marcorispoli/PCB-26-349/ORCAD/Specifiche Per Il Routing.docx

## Descrizione

La scheda in oggetto deriva dalla PCB/05-190-3 dalla quale sono stati eliminati alcuni blocchi funzionali ed è stato utilizzato il nuovo controllore della famiglia SAME come tutte le schede ultimamente prodotte.

Nello sbroglio delle piste e sul piazzamento dei componenti bisognerà rigorosamente rispettare gli isolamenti imposti tra aree galvanicamente separate.

All’interno della scheda esistono le seguenti aree circuitali galvanicamente separate:

- Area 24V: tale area fa capo al Ground con label “0”. A tale area fanno capo:
  - Il 24VDC di alimentazione della scheda;
  - Le uscite verso lo starter (conn. J11)
  - Le uscite verso L’interfaccia sincronismi (J12)
  - L’uscita del CAN-BUS.
- Area Microcontrollore: tale area fa capo al Ground con label “GND”. A quest’area attiene tutta la sezione di comando e lettura verso le aree attorno ad essa.
- Area Masmetro: tale area fa capo al Ground con label “GND_mAs”. A quest’area appartengono tutti i componenti della sezione mAsmetro.
- Area HV: a tale area isolate appartengono due zone di massa, “GND_HV” e “GND_HV1”. Tali zone sono unite a stella per ragioni funzionali (riduzione rumore da commutazione) ma non sono zone fra loro isolate galvanicamente.

Le piste e i componenti adiacente di aree isolate, reciprocamente, devono garantire un distanziamento minimo di 8mm, eventualmente rinforzabili con setti di 2 mm.

Tali setti inoltre devono obbligatoriamente essere inseriti al di sotto dei componenti di isolamento:

- U3, U21, U22, U19,U11,U5, U7,U26,U24,U1, U49,U50,U51,U52,U53,U54,U44,U45,U46,U47,U48,U32,U34,U30.

Il piazzamento si predilige sul lato componenti: tuttavia, a torto collo, potrà essere effettuato anche sul lato piste se il piazzamento o il routing dovesse essere critico, considerando il requisito di isolamento imposto.

La scheda dovrà essere sviluppata su 4 strati: eventualmente l’isolamento potrà essere garantito anche tracciando piste su Layers differenti.

## Parti Circuitali Derivate Da PCB 05/190

Allo scopo di riutilizzare quanto già fatto (e che funziona) si suggerisce di ispirarsi al routing della PCB190 per i componenti che attengono a UC3841 e PULSES, compreso anche la posizione dei connettori (facilmente identificabili tra le due schede anche se con references differenti)

## Dimensioni

La Scheda come punto di partenza dovrebbe essere alta 15cm (come la PCB190) e larga fino a J14 della PCB190, ora diventato J5.

## Piazzamento Suggerito

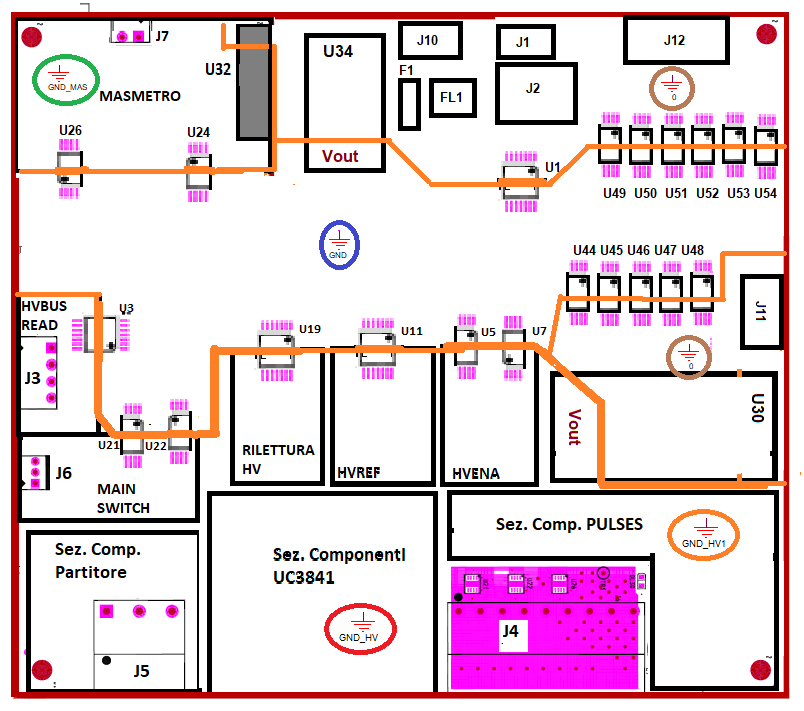
[picture p1: figure]
