marcorispoli/PCB-26-349/LST/RAZIONALIZZAZIONE LISTA PARTI PCB05-190-3.odt

REGOLATORI DC/DC

Id | PN/REFERENCE | ALTERNATIVE
1 | R-785.0-0.5 (RECOM) | TSR 0.5-2450 (TRACO POWER)
2 | R-78C15-1.0 (RECOM) | TSR 1-24150 (TRACO POWER)
3 | R-78C12-1.0 (RECOM) | TSR 1-24120 (TRACO POWER)
4 | ECOS1JA472CA oppure SLP472M050C5P3 | Alternativa a 85°, stesse dimensioni
5 | BNX002-01 | BNX012-01
6 | UC3841DW (obsoleto) | UC2841DW
7 | FSL400B THERMAL GAP 60x35mm | Equivalente ?
8 | DAC8512FSZ | DAC7611U TEXAS INSTRUMENT

ELIMINAZIONE COMPONENTI PER TENSIONE GRIGLIA (MAI USATA)

Id | REFERENCE | P/N/Prezzo
1 | J10 | MLSS156-2 (0.18)
2 | JP10 | Jumper
3 | OC12 | MOC3063SR2M (0.2)
4 | Q26 | BSS138K (0.01)
5 | R180
6 | R179
7 | TP31,TP33 | Test Points (0.3)
8 | PD5 | MB4S (0.2)
9 | C91
10 | C92 | ECA2CM100 (0.2)
11 | R170
12 | U38 | LR8N8-G (0.41)
13 | R172,R173,R176,R181,R182
14 | OC11 | TCMT4106 (0.5)
15 | R174,R175,R177,R178

SELEZIONE 2 FUOCHI INVECE CHE 4 FUOCHI ?:

Id | REFERENCE | P/N/Prezzo
1 | K11,K12 | 32.21.7.012.2000 RELAY PTH ( 2x 1,32)
NOTA: OCCORRE AGGIUNGERE UN PONTICELLO TRA PIN 12 e 14 DI K11
