marcorispoli/PCB-26-349/LST/ReleaseNote_LP05-190-3-ASSY00_r03.docx

# MODIFICA LISTA PARTI PCB-05-190 ASSY00

Le seguenti modifiche devono essere apportate alla lista parti in ASSY00:

Reference | Posizione precedente | Valore precedente | Nuova posizione | Nuovo valore | Note
R127 | 86 | 10K | 125 | 2K7 | Cambio valore
R136 | 86 | 10K | 87 | 6K8 | Cambio valore
