marcorispoli/PCB-26-349/LST/LP26-349-0.pdf

LISTA PARTI SCHEDA 26-349-0
Pos. Qtà Rif | Descrizione | Value | Package | PN | Costruttore | Note
1 | 41 C1,C2,C4,C5,C6,C8,C9,C10,C11
,C13,C14,C15,C27,C29,C30,C31 ,C33,C40,C51,C53,C55,C56,C57 ,C58,C60,C61,C62,C63,C64,C66 ,C67,C68,C87,C88,C89,C90,C92 ,C100,C101,C102,C103 | MLCC - SMD/SMT 50V 0.1uF X7R 0603 10% | 100nF | SMD0603 | C0603C104K5RACTU | KEMET
2 | 8 C7,C21,C32,C35,C43,C52,C54,
| C91 | MLCC - SMD/SMT 50V 0.01uF X7R 0603 5% | 10nF | SMD0603 | C0603C103J5RACTU | KEMET
3 | 10 C12,C16,C17,C18,C22,C23,C24,
| C37,C39,C50 | MLCC - SMD/SMT 25V 1uF X7R 0805 10% | 1uF | SMD0805 | 08053C105K4Z2A | KYOCERA
4 | 1 C19 | MLCC - SMD/SMT 100V 1nF COG 0805 5% | 1nF | SMD0805 | 08051A102J4T2A | KYOCERA
5 | 4 C20,C42,C44,C45 | MLCC - SMD/SMT 50V 1n5F COG 0805 5% | 1n5F | SMD0805 | C0805C152J5GACTU | KEMET
6 | 12 C25,C26,C70,C72,C75,C76,C78,
| C79,C81,C82,C84,C104 | Cond.Elt.Tantalio solido 35V SIZE C | 4u7 | 6032-28 | T491C475K035AT | KEMET
7 | 1 C28 | MLCC - SMD/SMT 2KV 820pF X7R1210 10% | 820pF | SMD1210 | 1210GC821KAT2A | KYOCERA
8 | 1 C34 | MLCC - SMD/SMT 2K5V 5n6F X7R1210 10% | 5n6F | SMD1825 | 825WC562KAT2A | KYOCERA
9 | 2 C36,C41 | MLCC - SMD/SMT 100V 470pF COG 0805 5% | 470pF | SMD0805 | 08051A471JAT2A | KYOCERA
10 | 1 C38 | MLCC - SMD/SMT 50V 47nF X7R 0603 10% | 47nF | SMD0805 | C0805C473K5RAC | KEMET
11 | 1 C46 | MLCC - SMD/SMT 100V 330pF COG 0805 5% | 330pF | SMD0805 | C0805C331J1GAC | KEMET
12 | 2 C47,C48 | MLCC - SMD/SMT 50V 56pF COG 0805 5% | 56pF | SMD0805 | C0805C560J5GACTU | KEMET
13 | 2 C49,C69 | Cond.Elt.Tantalio solido 35V SIZE D | 22uF | 7343-43 | T491X226K035AT7280 KEMET
14 | 1 C59 | MLCC - SMD/SMT 10V 10uF X7R 0805 10% | 10uF | SMD0805 | C0805C106K8RACTU | KEMET
15 | 1 C65 | MLCC - SMD/SMT 35V 4u7F X7R 1206 10% | 4u7 | SMD1206 | C1206C475K6RACTU | KEMET
17 | 6 C77,C80,C83,C86,C93,C94 | Safety Capacitors WCAP-CSSA X&Y Safety 470pF 5kV
| | 10% 1812 | 470pF | SMD1812 | 8853522110011 | WURTH
18 | 4 DL7,DL8,DL9,DL10 | Diodo led smd 0805 | VERDE | SMD0805 | KP-2012SGD | KINGBRIGHT
19 | 1 DL22 | Diodo led smd 0805 | BLU | SMD0805 | KP-2012PBC | KINGBRIGHT
20 11 DL24,DL26,DL27,DL28,DL29,DL
| 30,DL31,DL32,DL33,DL34,DL35 | Diodo led 90 gradi smd | GIALLO | APA2106SYCK/J3-
| | | | PRV

APA2106SYCK/J3-PRV KINGBRIGHT

21 | 1 DL25 | Diodo led 90 gradi smd | ROSSO | APA2106SECKJ3PRV APA2106SECK/J3-PRV KINGBRIGHT
22 | 1 D1 | ESD Protection compatible with CAN BUS | ESD2CAN24DBZRQ1 SOT23-3 | ESD2CAN24DBZRQ1 | TEXAS
23 | 8 D2,D4,D13,D14,D17,D18,D21,D
| 22 | Small Signal Switching Diodes SINGLE JUNC. 75V 4.0NS
| | COMP | 1N4148WT | SOD-523F-2 | 1N4148WT | ONSEMI
24 | 8 D5,D6,D7,D8,D9,D10,D11,D12 Rectifiers Diode, Superfast, SMA, 50V, 1A, 150C | ES1A | DO-214AC-2 | ES1A | DIOTEC
25 | 4 D15,D16,D19,D20 | Rectifiers 1.0A 1000V | RS1M-13-F | SMA-2 | RS1M-13-F | DIODES
26 | 1 D23 | Zener Diodes Zener Diode 3.0V 1000mW Surface Mount | PDZVTR3.0B | SOD-128-2 | PDZVTR3.0B | ROHM
27 | 2 D24,D25 | Rectifiers Diode, Superfast, SMA, 100V, 1A, 150C | ES1B | SMA | ES1B | DIOTEC
28 | 1 D26 | DIODO EDS BIDIREZIONALE | ESD5V0D3B-TP | SOD-323-2 | ESD5V0D3B-TP | MCC
29 | 1 FL1 | Circuiti filtro EMI 40 DB 50V 15A LEADED | BNX012-01 | | BNX012-01 | MURATA
30 | 1 F1 | FUSIBILE +PORTAFUSIBILE 0154002.DRT | 2A | | 0154002.DRT | LITTELFUSE
32 | 2 JP1,JP2 | HEADER DRITTO 2 PIN PASSO 2.54 | SIP | THT | TSW-102-09-T-S-RA | SAMTEC
33 | 1 J1 | NANOFIT HDR RA DLR 4CKT TIN BLK | 105314-1104 | | 105314-1104 | MOLEX
34 | 1 J2 | Connettore RJ45 8 Posizioni 90 gradi con leds | RJHSE538W01B | RJ45 | RJHSE538W01B | AMPHENOL
LP26-349-0.xlsx | 08/08/2026 | 1di4

Pos. Qtà Rif | Descrizione | Value | Package | PN | Costruttore | Note
35 | 2 J4,J5 | Mini-Fit Jr. Header, Dual Row, 10 vie | 39-30-1102 | 39-30-1102 | MOLEX
36 | 1 J8 | WR-BHD 2.54mm Male 6P Strt Gold Box Hdr | 61200621621 THT | 61200621621 | WURTH
37 | 1 J9 | CONN.HEADER 2X5 RIGHT ANG | 105314-2310 | THT | 105314-2310 | MOLEX
38 | 2 J10,J13 | CONN.HEADER 2X1 DRITTO P2 | 448179 | THT | 448179 | MOLEX
39 | 1 J11 | CONN.HEADER 2X3 DRITTO P2 | 105314-2306 | THT | 105314-2306 | MOLEX
40 | 1 J12 | TTerminali e capicorda 2.54MM CGRIDIII HDR 8P V DR
SHRD AU-E
105314-2208 | THT | 105314-2208 | MOLEX
41 | 1 K1 | RELE' STATO SOLIDO SMD | CPC1017NTR | SOP-4 | CPC1017NTR | IXYS
42 | 1 L1 | Filtro Modo Comune x CAN BUS | DLW32SH101XF2L | DLW32SH101XF2L | DLW32SH101XF2L | MURATA
43 | 2 L2,L3 | Ferrite Bead | BLM18BD102 | SMD0603 | BLM18BD102SN1D | MURATA
44 | 1 L4 | Common Mode Choke 470uH | 470uH | 744272471 | WUERTH
45 | 1 PT1 | Resettable Fuses - PPTC PTS0603 0.05A, 15V | PTS060315V005 | PTS060315V005 | EATON
46 | 2 P1,P3 | Trimmer Resistors - Through Hole 3/8" 5Kohms Sealed
Vertical Adjust
5K | 3296W-1-502LF | BOURNS
47 | 1 P2 | Trimmer Resistors - Through Hole 3/8" 10Kohms Sealed
Vertical Adjust
10K | 3296W-1-103LF | BOURNS
48 | 1 P4 | Trimmer Resistors - Through Hole 3/8" 20Kohms Sealed
Vertical Adjust
20K | 3296W-1-203LF | BOURNS

49 32 Q1,Q2,Q3,Q4,Q6,Q9,Q10,Q11,
Q14,Q15,Q16,Q17,Q18,Q19,Q2 0,Q21,Q22,Q23,Q24,Q25,Q26,Q 27,Q28,Q29,Q30,Q31,Q32,Q33, Q34,Q35,Q36,Q37
MOSFETs 60V 115mA N-Channel | 2N7002LT1G | SOT23 | 2N7002LT1G | ON
50 | 1 Q5 | Bipolar Transistors - BJT BJT, SOT-323, 45V, 100mA, PNP BC857BW | SOT323 | BC857BW | DIOTEC
51 | 2 Q7,Q8 | MOSFETs 60V N-Channel Enhancement Mode MOSFET PJE8472B_R1_00001 SOT-523-3 | PJE8472B_R1_00001 | PANJIT
52 | 1 R1 | Resistore thick film 1/10W 1% 0603 | 33R | SMD0603 | MULTICOMP
53 | 3 R2,R172,R173 | Resistore thick film 1/10W 1% 0603 | 120R | SMD0603 | MULTICOMP
54 14 R5,R7,R20,R40,R52,R56,R60,R
61,R77,R93,R103,R126,R132,R 189
Resistore thick film 1/10W 1% 0603 | 1K | SMD0603 | MULTICOMP
55 | 3 R6,R15,R46 | Resistore thick film 1/10W 1% 0603 | 2K2 | SMD0603 | MULTICOMP
56 10 R8,R66,R69,R87,R119,R128,R1
35,R141,R151,R166
Resistore thick film 1/10W 1% 0603 | 280R | SMD0603 | MULTICOMP

57 22 R9,R16,R19,R22,R23,R24,R59, R67,R70,R79,R89,R91,R94,R10 8,R109,R116,R125,R134,R139, R149,R160,R171

Resistore thick film 1/10W 1% 0603 | 10K | SMD0603 | MULTICOMP
58 | 1 R10 | Resistore thick film 1/4W 1% 1206 | 1K5 | SMD1206 | MULTICOMP
59 18 R11,R12,R13,R18,R21,R68,R71,
| R72,R73,R78,R90,R92,R111,R1 12,R118,R147,R157,R163 | Resistore thick film 1/10W 1% 0603 | 100K | SMD0603 | MULTICOMP
60 | 3 R14,R105,R114 | Resistore thick film 1/4W 1% 1206 | 1K3 | SMD1206 | MULTICOMP
61 | 9 R17,R55,R88,R100,R101,R102,
| R150,R159,R169 | Resistore thick film 1/10W 1% 0603 | 3K3 | SMD0603 | MULTICOMP
62 | 1 R25 | Resistore thick film 1/8W 1% 0805 | 2K2 | SMD0805 | MULTICOMP
63 | 2 R26,R64 | Resistore thick film 1/8W 1% 0805 | 3K3 | SMD0805 | MULTICOMP
64 | 2 R27,R39 | Resistore thick film 1/8W 1% 0805 | 1K | SMD0805 | MULTICOMP
LP26-349-0.xlsx | 08/08/2026 | 2di4

65 | 3 R28,R29,R30 | Resistore thick film 1/4W 1% 1206 | 1R | SMD1206 | MULTICOMP
66 | 1 R31 | Resistore thick film 1/4W 1% 1206 | 10K | SMD1206 | MULTICOMP
67 | 1 R32 | Resistore thick film 1/4W 1% 1206 | 18K | SMD1206 | MULTICOMP
68 | 2 R33,R204 | Resistore thick film 2W 1% 2512 | 33K | SMD 2512 | MULTICOMP
69 | 7 R34,R35,R36,R41,R42,R44,R45 Resistore thick film 1/4W 1% 1206 | 130K | SMD1206 | MULTICOMP
70 | 1 R37 | Resistore thick film 1/4W 1% 1206 | 220K | SMD1206 | MULTICOMP
71 | 1 R38 | Resistore thick film 1/8W 1% 0805 | 20K | SMD0805 | MULTICOMP
72 | 2 R43,R47 | Resistore thick film 1/4W 1% 1206 | 4K7 | SMD0805 | MULTICOMP
73 | 1 R48 | Resistore thick film 1/8W 1% 0805 | 5K6 | SMD0805 | MULTICOMP
74 | 1 R49 | Resistore thick film 1/8W 1% 0805 | 470R | SMD0805 | MULTICOMP
75 | 1 R50 | Resistore thick film 1/8W 1% 0805 | 4K32 | SMD0805 | MULTICOMP
76 | 1 R51 | Resistore thick film 1/10W 1% 0603 | 1K2 | SMD0603 | MULTICOMP
77 | 1 R53 | Resistore thick film 1/10W 1% 0603 | 8K45 | SMD0603 | MULTICOMP
78 27 R54,R123,R124,R131,R133,R13
| 8,R145,R146,R148,R155,R158,
| R164,R165,R170,R178,R179,R1
| 81,R183,R185,R187,R191,R193,
| R196,R197,R199,R201,R203 | Resistore thick film 1/10W 1% 0603 | 33K | SMD0603 | MULTICOMP
79 | 1 R57 | Resistore thick film 1/8W 1% 0805 | 390R | SMD0805 | MULTICOMP
80 | 1 R58 | Resistore thick film 1/10W 1% 0603 | 18K | SMD0603 | MULTICOMP
81 | 1 R62 | Resistore thick film 1/8W 1% 0805 | 10R | SMD0805 | MULTICOMP
82 | 1 R63 | Resistore thick film 1/8W 1% 0805 | 120K | SMD0805 | MULTICOMP
83 | 1 R65 | Resistore thick film 1/8W 1% 0805 | 220R | SMD0805 | MULTICOMP
84 | 1 R74 | Resistore thick film 1/10W 0.1% 10PPM 0603 | 2K67 | SMD0603 | RP0603BRD072K67L
85 | 2 R75,R84 | Resistore thick film 1/8W 1% 0805 | 10K | SMD0805 | MULTICOMP
86 | 1 R76 | Resistore thick film 1/8W 1% 0805 | 2K | SMD0805 | MULTICOMP
87 | 1 R80 | Resistore thick film 1/2W 1% 2512 | 100R | SMD2512 | MULTICOMP
88 | 1 R81 | Resistore thick film 1/10W 0.1% 10PPM 0603 | 33K | SMD0603 | RT0603BRC0733KL
89 | 1 R82 | Resistore thick film 1/10W 0.1% 10PPM 0603 | 100K | SMD0603 | RT0603BRB07100KL
90 | 1 R83 | Resistore thick film 1/10W 0.1% 10PPM 0603 | 11K | SMD0603 | RT0603BRD0711KL
91 | 1 R85 | Resistore thick film 1/10W 0.1% 10PPM 0603 | 14K | SMD0603 | RT0603BRB0714KL
92 | 1 R86 | Resistore thick film 1/8W 1% 0805 | 47R | SMD0805 | MULTICOMP
93 | 1 R95 | Resistore thick film 1/10W 1% 0603 | 330R | SMD0603 | MULTICOMP
94 | 1 R104 | Resistore thick film 1/4W 1% 1206 | 1K8 | SMD1206 | MULTICOMP
95 | 1 R106 | Resistore thick film 1/10W 1% 0603 | 12K | SMD0603 | MULTICOMP
96 | 2 R107,R115 | Resistore thick film 1/10W 1% 0603 | 15K | SMD0603 | MULTICOMP
97 | 1 R110 | Resistore thick film 1/10W 1% 0603 | 2K | SMD0603 | MULTICOMP
98 | 3 R113,R117,R188 | Resistore thick film 1/10W 1% 0603 | 4K7 | SMD0603 | MULTICOMP
99 16 R120,R121,R122,R129,R130,R1
| 36,R137,R142,R143,R144,R152,
| R153,R154,R162,R167,R168 | Resistore thick film 1/4W 1% 1206 | 2K | SMD1206 | MULTICOMP
100 1 R127 | Resistore thick film 1/10W 1% 0603 | 2K | SMD1206 | MULTICOMP
101 3 R140,R156,R161 | Resistore thick film 1/10W 1% 0603 | 47K | SMD0603 | MULTICOMP
102 1 R174 | Resistore thick film 1/8W 1% 0805 | 330K | SMD0805 | MULTICOMP
103 1 R175 | Resistore thick film 1/8W 1% 0805 | 22K | SMD0805 | MULTICOMP
104 13 R176,R177,R180,R182,R184,R1 86,R190,R192,R194,R195,R198, R200,R202 | Resistore thick film 1/10W 1% 0603 | 680R | SMD0603 | MULTICOMP
LP26-349-0.xlsx | 08/08/2026 | 3di4

105 12 TP2,TP5,TP6,TP10,TP11,TP13, TP15,TP16,TP23,TP24,TP26,TP 27

| Test Plugs & Test Jacks TEST POINT YELLOW | YEL | | | 5004 KEYSTONE
106 4 TP3,TP4,TP7,TP25 | Test Plugs & Test Jacks TEST POINT BLK .063 | BLK | | | 5006 KEYSTONE
107 2 TP12,TP28 | Test Plugs & Test Jacks TEST POINT (GREEN) | GRN | | | 5116 KEYSTONE
108 2 TP14,TP29 | Test Plugs & Test Jacks TEST POINT WHITE .040 | WHT | | | 5002 KEYSTONE
109 1 U1 | Digital Isolators Reinforced, fast, low-power 2-channel di | MAX22246CAWA/V+ SOIC-8 | MAX22246CAWA/V+ | ANALOG DEVICE
110 1 U2 | CAN Interface IC High-speed CAN transceiver | TJA1050T/CM,118 | SOIC-8 | TJA1050T | NXP
111 2 U3,U19 | Amplificatori di isolamento High Stability Isolated Error
| Amplifier | ADuM3195BRQZ | QSOP-16 | ADuM3195BRQZ | ANALOG DEVICE
112 2 U4,U6 | Logic Gates SSOP5 IC LOGIC 2INPUT AND GATE | BD7LS08ZG-CTL | SSOP-5 | BD7LS08ZG-CTL | ROHM
113 19 U5,U7,U21,U22,U26,U35,U36,U 41,U44,U45,U46,U47,U48,U49,U 50,U51,U52,U53,U54 | Transistor Output Optocouplers | TLP383D4BLLTLE | SO-6-4 | TLP383D4BLLTLE | TOSHIBA
114 4 U8,U37,U38,U42 | Supervisory Circuits Ultra-Lo 150nA | TPS3839G33DBZR | SOT23-3 | TPS3839G33 | TEXAS
115 2 U10,U23 | Op Amps Dual Operational Amp lifier TSSOP8 | LM358PT | TSSOP-8 | LM358PT | TEXAS
116 1 U11 | Digital Isolators 3-CHANNEL DIGITAL ISOLATORS | ADUM1310ARWZ-RL WIDE-SOIC | ADUM1310ARWZ-RL | ANALOG DEVICE
117 1 U12 | Digital to Analog Converters - DAC Single 12-bit DAC | MCP4821T-E/MS | MSOP8 | MCP4821T-E/MS | MICROCHIP
118 1 U13 | Timers & Support Products Single Precision Timer | NE555DR1G4 | SOIC-8 | NE555DR1G4 | TEXAS
119 1 U14 | Flip-Flops Dual CMOS | CD4013BPWR | TSSOP-14 | CD4013BPWR | TEXAS
120 3 U16,U17,U18 | Gate Drivers Dual 5A Hi-Spd Low- Side Pwr MOSFET | UCC27525DSDT | WSON-8 | UCC27525DSDT | TEXAS
121 1 U20 | Switching Controllers Prog Off-Line PWM Controller | UC3841DW | SOIC18-W | UC3841DW | TEXAS
123 1 U24 | Optoisolatore 5300VRMS singolo | SI8710AD-B-ISR | S-DIP-6 | SI8710AD-B-ISR | SKYWORKS
124 1 U25 | Analog Comparators VOLTAGE COMPARATOR | LM311MX/NOPB | SOIC-8 | LM311MX/NOPB | TEXAS
125 1 U27 | Voltage References 100-ppm/C precision micropower shunt
| vol
LM4040AIM3X-2.0/G4 SOT-23 | LM4040AIM3X-2.0/G4 | TEXAS
126 1 U28 | 32bit ARM 4F 1MB Flash, 256K Ram, 2xCAN-FD | SAME51J20A-AF | TQFP | SAME51J20A-AF | MICROCHIP
127 2 U29,U31 | DC/DC Converters 0.5A switching regulator in a SIP3
| package | RBT05W24S05 | RBT05W | RBT05W24S05 | MEANWELL
128 1 U30 | DC/DC Converters 18-36Vin 15Vout 1A 15W 2x1 Med Iso
| Reg | MDS15B-15 | MDS15B-15 | MDS15B-15 | MEANWELL
129 1 U32 | DC/DC Converters 1W DC/DC Converter isolated,
| unregulated | TMA-1515S | THT | TMA-1515S | TRACO
130 1 U33 | LDO Voltage Regulators 3.3V 1A Positive | NCP1117ST33T3G | SOT223 | NCP1117ST33T3G | ON
131 1 U34 | DC/DC Converters 9-36Vin 5V 0-600mA 3W DIP Med | MDS03F-05 | MDS03F-05 | MDS03F-05 | MEANWELL
132 1 U55 | Digital Isolators General-purpose qua d-channel 2/2 digit | ISO6742FDWR | SOIC-16 | ISO6742FDWR | TEXAS
133 2 U57,U58 | RS-422/RS-485 Interface IC 10MBps Full Duplex 5V | ADM4857ARZ-REEL7 SOIC-8 | ADM4857ARZ-REEL7 | ANALOG DEVICE
134 4 Z1,Z2,Z3,Z4 | Zener Diodes | PLVA650A,215 | SOT23-3 | PLVA650A,215 | NEXPERIA
LP26-349-0.xlsx | 08/08/2026 | 4di4
