marcorispoli/PCB-26-349/LST/LP05-190-3-ASSY01_r03.pdf

### LISTA PARTI SCHEDA 05-190-3-ASSY01_r03

Pos. Q.tà Rif. | | | Deacrizione | Valore | PN
1 | 2 | C1,C4 | Cond.Elt.Vert. D=25MM | 4700uF | ECOS1JA472CA oppure SLP472M050C5P3
2 | 10 | C2,C3,C6,C7,C8,C38,C76, C78,C85,C90,C100,C107 | Cond.CRM.Multilayer | 10uF | GRM31CR61H106KA12L
3 | 1 | C9 | Cond.Elt.Vert. D=16MM | 2200uF | ECA1VAM222X
4 | 41 | C10,C12,C13,C14,C15,C17, C21,C22,C23,C24,C25,C26, C28,C52,C61,C62,C71,C73, C84,C86,C93,C95,C97,C102, C104,C114,C115,C118,C119, C121,C122,C123,C124,C125, C127,C128,C129,C131,C132, C133,C134,C135,C136,C138, C141,C143,C146,C148,C149, C150,C151,C152,C153,C154, C155,C156 | Cond.CRM.Multilayer | 100nF | 08051C104K4T2A
5 | 16 | C11,C16,C32,C33,C34,C39, C41,C50,C63,C65,C67,C68 ,C94,C96,C98,C101,C103, C105,C142,C144,C145,C147 | Cond.CRM.Multilayer | 1uF | 08053C105K4Z2A
6 | 4 | C18,C19,C139,C140 | Cond.CRM.Multilayer | 15pF | C0805C150J5GACTU
7 | 1 | C35 | Cond.CRM.Multilayer | 1nF | 08051A102J4T2A
8 | 4 | C36,C55,C56,C57 | Cond.CRM.Multilayer | 1n5F | C0805C152J5GACTU
9 | 7 | C37,C45,C48,C51,C64,C66, C75 | Cond.CRM.Multilayer | 10nF | C0805C103K5RAC

### I COMPONENTI EVIDENZIATI IN ROSSO = NON MONTARE

### DATA:24/05/2017

LP05-190-3-ASSY01_r03 | 24/05/2017 | 1di18

Pos. Q.tà Rif. | | | Deacrizione | Valore | PN
10 | 22 | C40,C42,C43,C46,C69,C70, C74,C77,C79,C82,C83,C87, C91,C108,C109,C110,C111, C112,C113,C116,C117,C120, C130 | Cond.CRM.Multilayer | 1uF | C1210C105K5RAC-TU
11 | 1 | C44 | Cond.CRM.Multilayer | 820pF | 1210GC821KAT1A
12 | 1 | C47 | Cond.CRM.Multilayer | 5n6F | 1825WC562KAT1A
13 | 3 | C49,C54,C89 | Cond.CRM.Multilayer | 470pF | 08051A471JAT2A
14 | 2 | C53,C72 | Cond.CRM.Multilayer | 47nF | C0805C473K5RAC
15 | 1 | C58 | Cond.CRM.Multilayer | 330pF | C0805C331J1GAC
16 | 2 | C59,C60 | Cond.CRM.Multilayer | 56pF | C0805C560J5GACTU
17 | 2 | C80,C81 | Cond.Elt.Vert. D=18MM | 100uF | EEUEE2D101S
18 | 1 | C88 | Cond.CRM.Multilayer | 100pF | 08051A101JAT2A
19 | 1 | C92 | Cond.Elt.Vert. D=10MM | 10uF | ECA2CM100
20 | 0 | C99,C106 | Cond.Elt.Tantalio solido | 22uF | T491B226K016AT
21 | 1 | C126 | Cond.CRM.Multilayer | 330nF | 08055C334KAT2A
22 | 1 | C137 | Cond.ELT.Alluminio smd | 1000uF | EEETK1H102AM
23 | 31 | DL2,DL3,DL4,DL5,DL6,DL7, DL8,DL9,DL10,DL11,DL12, DL13,DL14,DL15,DL16,DL17, DL18,DL19,DL20,DL21,DL22, DL23,DL24,DL32,DL38,DL39, DL40,DL41,DL42,DL45,DL46 | DIODO LED SMD | GIALLO | KP-2012YD
24 | 9 | DL25,DL26,DL27,DL28,DL29, DL30,DL34,DL35,DL37,DL43, DL44 | DIODO LED SMD | VERDE | KP-2012SGD
25 | 1 | DL31 | DIODO LED SMD | ROSSO | KP-2012ID
26 | 2 | DL33,DL47 | DIODO LED SMD | BLU | KP-2012PBC
27 | 1 | DL36 | DIODO LED SMD | GIALLO | KP-2012YD
28 | 1 | DL48 | DIODO LED SMD | ARANCIO | SML-211DTT86K
29 | 14 | D1,D2,D5,D6,D8,D22,D23, D25,D26,D27,D28,D29,D30, D77 | DIODO RETT.VELOCE | ES1A | ES1A
LP05-190-3-ASSY01_r03 | 24/05/2017 | 2di18

Pos. Q.tà Rif. | | | Deacrizione | Valore | PN
30 | 33 | D9,D10,D11,D12,D13,D14, D16,D17,D18,D19,D20,D21, D24,D31,D34,D36,D40,D41, D53,D54,D55,D56,D57,D58, D59,D60,D61,D62,D63,D64, D65,D66,D67,D68,D69,D70, D73,D75,D76,D80,D81 | DIODO SEGNALE | 1N4148 | 1N4148WT
31 | 4 | D32,D33,D35,D37 | DIODO RETT.VELOCE | RS1M-13-F | RS1M-13-F
32 | 7 | D38,D39,D42,D43,D48,D49,D 50 | DIODO RETT.VELOCE | ES1B | ES1B
33 | 2 | D44,D45 | DIODO SEGNALE | BAT754S | BAT754S
34 | 2 | D46,D47 | DIODO RETT.VELOCE | SK56C | SK56C
35 | 0 | D52 | DIODO RETT.VELOCE | ES1G | ES1G
36 | 3 | FL1,FL2,FL3 | FILTRO EMI DC | BNX002-01 | BNX002-01
37 | 1 | FL4 | FILTRO SOPPRESSIONE | NFM21PC474R1C3 | NFM21PC474R1C3D
38 | 2 | F1,F2 | FUSIBILE +PORTAFUSIBILE | 5AT | 0154005.DRT
39 | 2 | F3,F4 | FUSIBILE +PORTAFUSIBILE | 1AT | 0154001.DRT
41 | 7 | JP9,JP10,JP11,JP12,JP13, JP14,JP15 | HEADER DRITTO 2 PIN PASSO 2.54 | TSW-102-09-T-S-RA | TSW-102-09-T-S-RA
42 | 1 | J1 | CONNETTORE 4 VIE P.3.81 | MC 1.5/4 3.81 | 1803293
43 | 2 | J2,J21 | CONNETTORE 2 VIE P.3.81 | MC 1.5/2 3.81 | 1803277
44 | 2 | J3,J23 | HEADER BOXED 2 X 3 PIN P.2.54 | Spina 3x2 ICD | 9185066324
45 | 2 | J4,J5 | CONNETTORE 20PIN P.1.27 | 9-338069-0 | 9-338069-0
46 | 1 | J6 | CONNETTORE 9 PIN P.5.08 90° | MSTB 2,5/ 9-G-5,08 | 1759088
47 | 1 | J7,J13 | CONNETTORE 3 PIN P.7.62 90° | GMSTBA 2,5/ 3-G-7,62 | 1766246
48 | 1 | J8,J17 | CONN. DRITTO 3 PIN PASSO 2.54 | MLSS-100-3 | MLSS100-3
49 | 1 | J9 | CONNETTORE 7 PIN P.7.62 90° | GMSTBA 2,5/7-G-7,62 | 1766288
50 | 1 | J10 | CONN. DRITTO 2 PIN PASSO 3.96 | MASCON-156 | MLSS156-2
51 | 0 | J11 | CONNETTORE 4 PIN P.7.62 90° | GMSTBA 2,5/ 4-G-7,62 | 1766259
52 | 0 | J12 | CONN. 90° 3 PIN PASSO 2.54 | MLAS-3 | MLAS156-3
53 | 1 | J14 | CONNETTRORE 4 VIE P.3.81 | MC 1.5/4 3.81 | 1803293
54 | 2 | J15,J16 | CONN. 2 X 5 P.2MM DRITTO | 98414-G06-10ULF | 98414-G06-10ULF
55 | 0 | J18 | CONN. DRITTO 2 PIN PASSO 2.54 | MLSS-100-2 | MLSS100-2
56 | 0 | J19 | CONN. 90° 2 X 5 PASSO 3 MM | 4-794618-0 | 4-794618-0
LP05-190-3-ASSY01_r03 | 24/05/2017 | 3di18

Pos. Q.tà Rif. | | | Deacrizione | Valore | PN
57 | 0 | J20 | CONN. DRITTO 2 X 5 P.127 | 1-338068-0 | 1-338068-0
58 | 1 | J22 | CONN. AMPMODU II 6 X 2 DRITTO | 5-103168-1 | 5-103168-1
59 | 1 | J24 | PRED.NE PER XR2206 EXT | NON MONTARE
60 | 1 | J25 | TERMINALE DRITTO FASTON | 6.35 X 0.84 | 63849-1 TE
61 | 8 | K1,K2,K3,K5,K6,K7,K8,K9 | RELE' STATO SOLIDO SMD | CPC1017NTR | CPC1017NTR
62 | 1 | K4 | RELE' STATO SOLIDO PTH | CPC1918 | CPC1918
63 | 3 | K10,K11,K12 | RELE' 12V 6A DOPPIO | SPDT-6A | 32.21.7.012.2000
64 | 2 | OC1,OC2 | OPTOISOLATORE QUADRUPLO | TCMT4100 | TCMT4100
65 | 11 | OC3,OC6,OC8,OC10,OC18,OC 19,OC20,OC21,OC22, OC23,OC29,OC30 | OPTOISOLATORE SINGOLO | TCMT1103 | TCMT1103
66 | 1 | OC11 | OPTOISOLATORE QUADRUPLO | TCMT4106 | TCMT4106
67 | 1 | OC12,OC17 | OPTOISOLATORE SINGOLO | MOC3063SR2M | MOC3063SR2M
68 | 0 | OC13,OC14,OC15,OC16 | OPTOISOLATORE SINGOLO | FODM3053 | FODM3053R2V_NF098
69 | 1 | PCB1 | MODULO METALTRONICA | PCB-11-219 | PCB-11-219-1
70 | 2 | PD1,PD2 | PONTE DIODI PTH | GBU6-03 | GBU603
71 | 2 | PD3,PD4 | PONTE DIODI SMD | DF01S | DF01S
72 | 1 | PD5 | PONTE DIODI SMD | MB4S | MB4S-E3/45
73 | 4 | P1,P5,P7,P9 | TRIMMER MULTIGIRI VERTICALE | 5K | 3296W-1-502LF
74 | 3 | P2,P3,P11 | TRIMMER MULTIGIRI VERTICALE | 100K | 3296W-1-104LF
75 | 1 | P4 | TRIMMER MULTIGIRI VERTICALE | 10K | 3296W-1-103LF
76 | 2 | P6,P8 | TRIMMER MULTIGIRI VERTICALE | 20K | 3296W-1-203LF
77 | 1 | P10 | TRIMMER MULTIGIRI VERTICALE | 20R | 3296W-1-200LF
78 | 6 | Q4,Q8,Q9,Q27,Q29,Q34, Q35 | MOSFET CANALE N 100V 0.85A | BSH114 | BSH114
79 | 4 | Q5,Q6,Q25,Q28 | TRANSISTOR NPN 45V 0.1A | BC847BW | BC847BW
80 | 1 | Q7 | TRANSISTOR NPN 45V 0.1A | BC857BW | BC857BW
81 | 9 | Q10,Q11,Q12,Q13,Q14,Q15, Q17,Q19,Q20,Q22,Q24, Q26,Q30,Q31,Q32,Q33 | MOSFET CANALE N 50V 0.2A | BSS138K | BSS138K
82 | 0 | Q16,Q18,Q21,Q23 | | BTA16-BW (no snub) | BTA16-600BWRG
83 | 1 | R1 | RESISTORE THICK FILM 1/8W 1% | 270R | CRG0805F270R
84 | 1 | R2 | RESISTORE THICK FILM 1/8W 1% | 3K | CRCW08053K00FKEA
LP05-190-3-ASSY01_r03 | 24/05/2017 | 4di18

Pos. Q.tà Rif. | | | Deacrizione | Valore | PN
85 | 32 | R3,R4,R5,R8,R48,R74,R89, R103,R109,R115,R121,R122, R123,R128,R132,R151,R158, R229,R230,R236,R245,R247, R249,R251,R270,R271,R276, R278,R279,R280,R281,R290 | RESISTORE THICK FILM 1/8W 1% | 1K | CRCW08051K00FKEA
86 | 24 | R6,R13,R15,R84,R114,R139,R 142,R146,R147,R161,R169,R 173,R176,R181,R182,R201,R 203,R206,R208,R219,R222,R 225,R238,R239,R286,R343,R 355,R356 | RESISTORE THICK FILM 1/8W 1% | 10K | CRCW080510K0FKEA
87 | 5 | R7,R44,R45,R126,R136 | RESISTORE THICK FILM 1/8W 1% | 6K8 | CRCW08056K80FKEA
88 | 3 | R9,R129,R133,R202,R204, R205,R207,R209,R210 | RESISTORE THICK FILM 1/8W 1% | 100K | CRCW0805100KFKEA
89 | 19 | R10,R25,R26,R27,R28,R29, R31,R78,R82,R93,R97,R112, R150,R159,R232,R254,R269, R274,R341,R342 | RESISTORE THICK FILM 1/8W 1% | 4K7 | PANERJ6ENF4701V
90 | 9 | R14,R17,R18,R19,R20,R21, R23,R105,R111,R130 | RESISTORE THICK FILM 1/8W 1% | 390R | CRCW0805390RFKEA
91 | 1 | R16 | RESISTORE SMD 2616 2W | 10R | SMW210RJT
92 | 37 | R40,R41,R42,R43,R47,R50, R51,R52,R53,R54,R55,R56, R57,R58,R59,R60,R61,R62, R63,R64,R65,R66,R67,R68, R69,R70,R71,R73,R80,R88, R96,R231,R235,R261,R291, R302,R310 | RESISTORE THICK FILM 1/8W 1% | 2K2 | PANERJ6ENF2201V
93 | 7 | R46,R49,R72,R104,R118, R131,R134 | RESISTORE THICK FILM 1/8W 1% | 3K3 | CRCW08053K30FKEA
94 | 3 | R75,R119,R144 | RESISTORE THICK FILM 1/8W 1% | 220R | CRG0805F220R
95 | 4 | R76,R157,R164,R336 | RESISTORE THICK FILM 1/8W 1% | 2K | CRCW08052K00FKEA
96 | 1 | R77 | RESISTORE THICK FILM 1/4W 1% | 1K5 | CRCW12061K50FKEA
LP05-190-3-ASSY01_r03 | 24/05/2017 | 5di18

Pos. Q.tà Rif. | | | Deacrizione | Valore | PN
97 | 13 | R79,R95,R102,R106,R211, R213,R215,R220,R221,R223, R227,R252,R273 | RESISTORE THICK FILM 1/8W 1% | 33K | CRCW080533K0FKEA
98 | 1 | R81 | RESISTORE THICK FILM 1/4W 1% | 18K | CRCW120618K0FKEA
99 | 4 | R83,R113,R141,R216 | RESISTORE THICK FILM 1/8W 1% | 18K | CRCW080518K0FKEA
100 | 8 | R85,R86,R87,R90,R91,R92, R94,R170 | RESISTORE THICK FILM 1/4W 1% | 130K | CRCW1206130KFKEA
101 | 14 | R98,R145,R148,R149,R152, R155,R165,R166,R167,R179, R189,R191,R196,R199,R244, R246,R248,R250 | RESISTORE THICK FILM 1/8W 1% | 5K6 | CRCW08055K60FKEA
102 | 1 | R99 | RESISTORE THICK FILM 1/8W 1% | 4K32 | CRCW08054K32FKEA
103 | 16 | R100,R255,R262,R272,R282, R284,R345,R346,R347,R348, R349,R350,R351,R352,R353, R354 | RESISTORE THICK FILM 1/8W 1% | 470R | CRCW0805470RFKEA
104 | 2 | R101,R171 | RESISTORE THICK FILM 1/8W 1% | 1K2 | CRCW08051K20FKEA
105 | 4 | R107,R108,R160,R163, | RESISTORE THICK FILM 1/8W 1% | 56K | CRCW080556K0FKEA
106 | 1 | R110 | RESISTORE THICK FILM 1/8W 1% | 8K45 | CRCW08058K45FKEA
107 | 1 | R116 | RESISTORE THICK FILM 1/8W 1% | 10R | CR0805-FX-10R0GLF
108 | 1 | R117 | RESISTORE THICK FILM 1/8W 1% | 120K | CRCW0805120KFKEA
109 | 2 | R120,R358 | RESISTORE THICK FILM 1/8W 1% | 15R | CRG0805F15R
110 | 1 | R124 | RESISTORE THICK FILM 1/4W 1% | 82R | CRCW120682R0FKEAHP
111 | 3 | R125,R237,R287 | RESISTORE THICK FILM 1/8W 1% | 100R | PHY232273461001
112 | 2 | R135,R162 | RESISTORE THICK FILM 1/8W 1% | 12K | CPF0805B12KE1
113 | 1 | R137 | RESISTORE THICK FILM 1/8W 1% | 47R | CRCW080547R0FKEA
114 | 1 | R138 | RESISTORE THICK FILM 1/8W 1% | 16K5 | MCTC0525B1652T5E
115 | 3 | R140,R172,R212 | RESISTORE THICK FILM 1/8W 1% | 39K | CRCW080539K0FKEA
116 | 3 | R143,R214,R228 | RESISTORE THICK FILM 1/8W 1% | 27K | CRCW080527K0FKEA
117 | 2 | R153,R154 | RESISTORE THICK FILM 1/8W 1% | 200R | CRCW0805200RFKEA
118 | 6 | R156,R174,R175,R177,R178, R180,R185,R186,R187,R193, R197 | RESISTORE THICK FILM 1/8W 1% | 820R | PANERJ6GEYJ821V
119 | 1 | R168 | RESISTORE THICK FILM 1/4W 1% | 15K | CRCW120615K0FKEAHP
LP05-190-3-ASSY01_r03 | 24/05/2017 | 6di18

Pos. Q.tà Rif. | | | Deacrizione | Valore | PN
120 | 0 | R183 | RESISTORE THICK FILM 1/4W 1% | 430K | CRCW0805430KFKEA
121 | 0 | R184 | RESISTORE THICK FILM 1/8W 1% | 1K | CR1206-FX-1001ELF
122 | 0 | R188,R190,R194,R195,R198, R200 | RESISTORE THICK FILM 1/4W 1% | 100R | CRCW1206100RFKEAHP
123 | 0 | R192 | RESISTORE THICK FILM 1/4W 1% | 47R | CRCW120647R0FKEA
124 | 2 | R217,R344 | RESISTORE THICK FILM 1/8W 1% | 47K | CRCW080547K0FKEA
125 | 3 | R218,R233,R234,R357,R127 | RESISTORE THICK FILM 1/8W 1% | 2K7 | CRCW08052K70FKEA
126 | 2 | R224,R243 | RESISTORE THICK FILM 1/8W 1% | 20K | CRCW080520K0FKEA
127 | 1 | R226 | RESISTORE THICK FILM 1/8W 1% | 8K2 | CRCW08058K20FKEA
128 | 2 | R241,R242 | RESISTORE THICK FILM 1/4W 1% | 220K | CRCW1206220KFKEA
129 | 4 | R257,R258,R259,R260 | RESISTORE THICK FILM 1/4W 1% | 249R | CRCW1206249RFKEA
130 | 1 | R275 | RESISTORE THICK FILM 1/8W 1% | 560R | CRCW0805560RFKEA
131 | 1 | R283 | RESISTORE THICK FILM 1/8W 1% | 120R | CRCW0805120RFKEA
132 | 2 | R285,R288 | RESISTORE THICK FILM 1/8W 1% | 1R | ERJ6RQF1R0V
133 | 1 | R289 | RESISTORE THICK FILM 1/8W 1% | 330R | Vari
134 | 1 | R338 | RESISTORE THICK FILM 1/8W 1% | 0R | CRCW08050000ZSTA
135 | 1 | R339,R340,R240 | RESISTORE THICK FILM 1/8W 1% | 10K | PANERJ6GEYJ103V
136 | 1 | TF1 | TRASFORMATORE METALTRONICA | TF108 | TF108-MEDEL
137 | 1 | TF2 | TRASFORMATORE METALTRONICA | TF208 | TF208-MEDEL
138 | 3 | TH1,TH3,TH4 | FUSIBILE RIPRISTINABILE | 500mA,60V | SMD050F-2
139 | 1 | TH2 | FUSIBILE RIPRISTINABILE | 100mA | MICROSMD010F
140 | 6 | TP1,TP3,TP4,TP5,TP6,TP7 | TEST POINT FORO SU PCB 1MM | ROSSO | RS200-207
141 | 2 | TP2,TP13 | TEST POINT FORO SU PCB 1MM | NERO | RS200-203
142 | 2 | TP8,TP11 | TEST POINT FORO SU PCB 1MM | BIANCO | RS200-201
143 | 17 | TP9,TP10,TP12,TP14,TP16, TP17,TP18,TP20,TP21,TP22,T P25,TP29,TP33,TP34,TP37,TP 38,TP39 | TEST POINT FORO SU PCB 1MM | GIALLO | RS200-202
144 | 2 | TP31,TP36 | TEST POINT FORO SU PCB 1MM | VERDE | RS200-208
145 | 1 | U1 | REG. TENSIONE 12 V 1 A | R-78C12-1.0 | R-78C12-1.0
146 | 1 | U2 | REG. TENSIONE 5 V 0.5A | RECOM-7805 | R-785.0-0.5
147 | 1 | U3 | REG. TENSIONE NEG 12 V 1 A | LM7912 | LM7912CT
148 | 2 | U4,U30 | REG. TENSIONE ADJ | LM317A | LM317AEMP/NOPB
LP05-190-3-ASSY01_r03 | 24/05/2017 | 7di18

Pos. Q.tà Rif. | | | Deacrizione | Valore | PN
149 | 1 | U5 | REG. TENSIONE 15 V 1 A | R-78C15-1.0 | R-78C15-1.0
150 | 1 | U6 | CIRCUITO INTEGRATO | SN74LVC138AD | SN74LVC138ADRG4
151 | 1 | U7 | MICROCONTROLLORE | PIC16F877A | PIC16F877A-I/PT
152 | 2 | U8,U11 | CIRCUITO INTEGRATO | CD4555B | CD4555BM
153 | 2 | U9,U10 | CIRCUITO INTEGRATO | MCP23S17 | MCP23S17-E/SS
154 | 1 | U12 | CIRCUITO INTEGRATO | CD4023BPW | CD4023BPW
155 | 1 | U19 | CIRCUITO INTEGRATO | NE555DT | NE555DT
156 | 1 | U20 | CIRCUITO INTEGRATO | CD4013B | CD4013BPWR
157 | 3 | U21,U22,U26 | CIRCUITO INTEGRATO | UCC27525DSD | UCC27525DSDT
158 | 2 | U23,U36 | CIRCUITO INTEGRATO | DAC8512FSZ | DAC8512FSZ
159 | 5 | U24,U27,U31,U34,U43 | CIRCUITO INTEGRATO | LM358ADGKRG4 | LM358ADGKRG4
160 | 4 | U25,U28,U44,U54 | CIRCUITO INTEGRATO | IL300-DEFG-X007 | IL300-DEFG-X007
161 | 1 | U29 | CIRCUITO INTEGRATO | UC3841DW | UC3841DW
162 | 1 | U32 | CIRCUITO INTEGRATO | LM331N/NOPB | LM331N/NOPB
163 | 1 | U35 | CIRCUITO INTEGRATO | LM1458M | LM1458M
164 | 1 | U37 | CIRCUITO INTEGRATO | XR2206CP | XR2206CP
165 | 1 | U38 | CIRCUITO INTEGRATO | LR8N8-G | LR8N8-G
166 | 0 | U39,U40 | CIRCUITO INTEGRATO | LM324PT | LM324PT
167 | 0 | U41,U42 | CIRCUITO INTEGRATO | ACS712ELCTR-05B-T | ACS712ELCTR-05B-T
168 | 1 | U45 | CIRCUITO INTEGRATO | MCP6S28-I/SL | MCP6S28-I/SL
169 | 2 | U46,U47 | CIRCUITO INTEGRATO | SN75HVD3082EDG4 | SN75HVD3082EDG4
170 | 0 | U48 | CIRCUITO INTEGRATO | MAX6661AEE | MAX6661AEE
171 | 0 | U49 | CIRCUITO INTEGRATO | L78L05ACUTR | L78L05ACUTR
172 | 0 | U50 | CIRCUITO INTEGRATO | ADUM2200BRWZ | ADUM2200BRWZ
173 | 0 | U51 | CIRCUITO INTEGRATO | SN65LVDS9638DGKR | SN65LVDS9638DGKR
174 | 2 | U52,U61 | CIRCUITO INTEGRATO | LM317AEMP/NOPB | LM317AEMP/NOPB
175 | 1 | U55 | CIRCUITO INTEGRATO | MCP6S22-I/MS | MCP6S22-I/MS
176 | 0 | U56,U57,U58,U59 | CIRCUITO INTEGRATO | SN65HVD3085EDGK | SN65HVD3085EDGK
177 | 1 | U60 | MICROCONTROLLORE | PIC16F876A-I/SS | PIC16F876A-I/SS
178 | 1 | U62 | DC/DC OPTOISOLATO 15/15V | TMA1515S | TMA1515S
179 | 1 | V1 | VARISTORE | V18MLA1210H | V18MLA1210H
180 | 1 | V4 | VARISTORE | V33MLA1206H | V33MLA1206H
181 | 0 | X1 | QUARZO | SMDB3 | SMDB3
182 | 1 | Y1 | QUARZO | 3.6864MHz | 9C-3.6864MAAJ-T
LP05-190-3-ASSY01_r03 | 24/05/2017 | 8di18

Pos. Q.tà Rif. | | | Deacrizione | Valore | PN
183 | 1 | Y2 | QUARZO | 16MHZ | 7A-16.000MAAJ-T
184 | 1 | | DISSIPATORE PER PCB 11-219-XX | MQ11194-01 | METALTRONICA
185 | 1 | | THERMAL-GAP DENKA | FSL400B | 35mm x 60mm
186 | 8 | | DISTANZIALI NYLON | ESSENTRA SRS4-5-01 | H=7.9 mm
187 | 3 | | VITE VTSTC | M3 X 16 INOX | X FISSAGGIO MODULO
188 | 5 | | DADI M3 INOX
189 | 5 | | ROSETTA ELASTICA INOX Øi 3.2 mm
190 | QB | | THERMAL PAD DENKA | FSL100B (1MM)
191 | 2 | | VITE VTCEI | M3 X 10 INOX
198 | 1 | | CIRCUITO STAMPATO | | CS/05-190-3
| NOTE
1 UTILIZZARE ULTIMA REVISIONE RILASCIATA 2 INTERPOSTO TRA PCB1 E POS.184
3 INSERITI NEI FORI FISSAGGIO SCHEDA 4 UTILIZZATI PER FISSAGGIO PCB1
5 UTILIZZATI PER FISSAGGIO PD1/PD2
LP05-190-3-ASSY01_r03 | 24/05/2017 | 9di18

Footprint
EV25

SMD1206

EV16
SMD0805-MET

SMD0805-MET

SMD0805-MET
SMD0805-MET
SMD0805-MET
SMD0805-MET
LP05-190-3-ASSY01_r03 | 24/05/2017 | 10di18

Footprint
SMD1210

SMD1210
SMD1825-LD13-AVX
SMD0805-MET
SMD0805-MET
SMD0805-MET
SMD0805-MET
EV18
SMD0805-MET
EV10
ETANT-B-R
SMD0805-MET
ALLSIZEL
LED0805-MET-1/2

LED0805-MET-1/2

LED0805-MET-1/2
LED0805-MET-1/2
LED0805-MET-12
LED0805-MET-1/2
SMA-1/2
LP05-190-3-ASSY01_r03 | 24/05/2017 | 11di18

Footprint
SOD523F1-2

SMA-1/2
SMA-1/2

SOT23-123
SMC-1/2
SMA-1/2
BNX002-01
NFM21PC-0805
LITTLEFUSE-154
LITTLEFUSE-154
2SIP100

MC1.5-4-G-3.81
MC1.5-2-G-3.81
SEK_0918506X32X_HARTING
TYCO-2-338069-0
MSTB2.5-5.08-9
GMSTB2.5-7.62-3
MLSS100-03
GMSTB2.5-7.62-7
MLSS156-02
GMSTB2.5-7.62-4
MLAS156-03
MC1.5-4-G-3.81
FCI-98414-G-06-10
MLSS100-02
TYCO-4-794618-0
LP05-190-3-ASSY01_r03 | 24/05/2017 | 12di18

Footprint
TYCO-1-338068-0
5-103168-1-TYCO
5SIP100
FAS1
CPC1017N-CLARE
CPC1918-CLARE+DISS
32.21- FINDER
MINIFLAT16
MINIFLAT4

MINIFLAT16
PSMD6
MFP4
PCB-11-219
GBU6H
DF01S
TO269AA
3296W-BOURNS
3296W-BOURNS
3296W-BOURNS
3296W-BOURNS
3296W-BOURNS
SOT23-123

SOT323_123
SOT323_123
SOT23-123

TO220AB
SMD0805-MET
SMD0805-MET
LP05-190-3-ASSY01_r03 | 24/05/2017 | 13di18

Footprint
SMD0805-MET

SMD0805-MET

SMD0805-MET
SMD0805-MET

SMD0805-MET

SMD0805-MET

SM2-TYCO
SMD0805-MET

SMD0805-MET

SMD0805-MET
SMD0805-MET
SMD1206
LP05-190-3-ASSY01_r03 | 24/05/2017 | 14di18

Footprint
SMD0805-MET

SMD1206
SMD0805-MET
SMD1206

SMD0805-MET

SMD0805-MET
SMD0805-MET

SMD0805-MET
SMD0805-MET
SMD0805-MET
SMD0805-MET
SMD0805-MET
SMD0805-MET
SMD1206
SMD0805-MET
SMD0805-MET
SMD0805-MET
SMD0805-MET
SMD0805-MET
SMD0805-MET
SMD0805-MET
SMD0805-MET

SMD1206

LP05-190-3-ASSY01_r03 | 24/05/2017 | 15di18

Footprint
SMD0805-MET
SMD1206
SMD1206

SMD1206
SMD0805-MET
SMD0805-MET

SMD0805-MET
SMD0805-MET
SMD1206
SMD1206
SMD0805-MET
SMD0805-MET
SMD0805-MET
SMD0805-MET
SMD0805-MET
SMD0805-MET
TF108-MEDEL-C
TF208-MEDEL+5MM
SMD050F_TYCO
MICROSMD010F
TESTPOINT_1MM
TESTPOINT_1MM
TESTPOINT_1MM
TESTPOINT_1MM

TESTPOINT_1MM
R-78CXX-1.0-RECOM
R-78XX-0.5-RECOM
TO220RV
SOT223-1234
LP05-190-3-ASSY01_r03 | 24/05/2017 | 16di18

Footprint
R-78CXX-1.0-RECOM
SOG.050/16/WG.244/L.394
QUAD.80M/44/WG12.00
SOG.050/16/WG.244/L.394
SOG.65M/28/WG8.20/L10.80
PW-14 TEXAS
SO8
PW-14 TEXAS
SON65P300X300X80-9N
SO8
SOG.65M/8/WG5/L3.1
SMD-8
SOG.050/18/WG.420/L.462
B8
SO8
B16
SOT89_123
SOG.65M/14/WG6.4/L5.00
SO8
SO16
SO8
SOG.025/16/WG.244/L.196
SOT89_123
SOG.050/16/WG.420/L.412
SOG.65M/8/WG5/L3.1
SOT223-1234
SOG.65M/8/WG4.9/L3.00
SOG.65M/8/WG5/L3.1
SOG.65M/28/WG8.20/L10.80
TMHXXXXS-TRACO
SMD1210
SMD1206
SOT23-123
HC49SMD
LP05-190-3-ASSY01_r03 | 24/05/2017 | 17di18

Footprint
TA-5X3.2-TXC

VEDI NOTA 2
VEDI NOTA 3

VEDI NOTA 4
VEDI NOTA 4,5
VEDI NOTA 4,5
VEDI NOTA 5
VEDI NOTA 5
METALTRONICA
LP05-190-3-ASSY01_r03 | 24/05/2017 | 18di18
