marcorispoli/PCB-26-349/LST/LST05-190-3_Assy01_r05.pdf

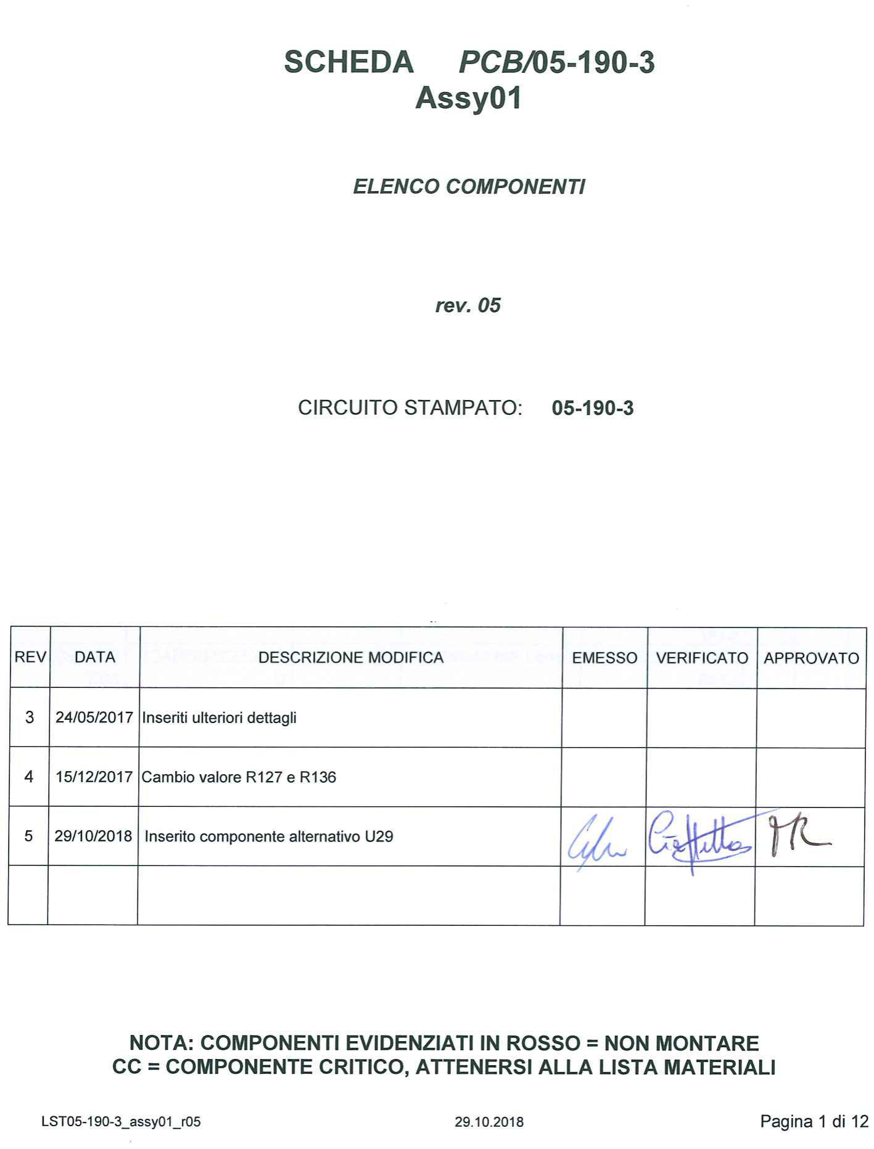
[picture p2: page 1]

NOTA: COMPONENTI EVIDENZIATI IN ROSSO = NON MONTARE CC = COMPONENTE CRITICO, ATTENERSI ALLA LISTA MATERIALI
LST05-190-3_assy01_r05 | 29.10.2018 | Pagina 2 di 12

Pos. Q.tà Rif. Descrizione Valore PN Footprint 1 2 C1, C4 Cond.Elt.Vert.
D=25MM
| 4700uF ECOS1JA472CA
oppure
SLP472M050C5P3
| | EV25
2 10 C2, C3, C6, C7, C8,
C38, C76, C78, C85,
C90, C100, C107

Cond.CRM.Multilayer 10uF GRM31CR61H106K
A12L
| | SMD1206
3 1 C9 Cond.Elt.Vert.
D=16MM

2200uF ECA1VAM222X EV16
4 41 C10, C12, C13, C14,
C15, C17, C21, C22,
C23, C24, C25, C26,
C28, C52, C61, C62,
C71, C73, C84, C86,
C93, C95, C97,
C102, C104, C114,
| C115, C118, C119,
5 16 C11, C16, C32, C33, 6 4 C18, C19, C139, | C154, C155, C156 C34, C39, C41, C50, C63, C65, C67, C68, C94, C96, C98, C101, C103, C105, C142, C144, C145, C147 | Cond.CRM.Multilayer 1uF 08053C105K4Z2A SMD0805-Cond.CRM.Multilayer 15pF C0805C150J5GACT | | MET SMD0805-
10 22 C40, C42, C43, C46, | C69, C70, C74, C77, C79, C82, C83, C87, C91, C108, C109, C110, C111, C112, C113, C116, C117, C120, C130 | Cond.CRM.Multilayer 1uF C1210C105K5RAC- | TU | SMD1210

C121, C122, C123,
C124, C125, C127,
C128, C129, C131,
C132, C133, C134,
C135, C136, C138,
C141, C143, C146,
C148, C149, C150,
C151, C152, C153,

Cond.CRM.Multilayer 100nF 08051C104K4T2A SMD0805-MET

C140

U

MET
7 1 C35 Cond.CRM.Multilayer 1nF 08051A102J4T2A SMD0805-MET
8 4 C36, C55, C56, C57 Cond.CRM.Multilayer 1n5F C0805C152J5GACT
U

SMD0805-
MET
9 7 C37, C45, C48, C51,
C64, C66, C75

Cond.CRM.Multilayer 10nF C0805C103K5RAC SMD0805-MET
11 1 C44 Cond.CRM.Multilayer 820pF 1210GC821KAT1A SMD1210

LST05-190-3_assy01_r05 | 29.10.2018 | Pagina 3 di 12

Pos. Q.tà Rif. Descrizione Valore PN Footprint 12 1 C47 Cond.CRM.Multilayer 5n6F 1825WC562KAT1A SMD1825-
| | LD13-AVX
13 3 C49, C54, C89 Cond.CRM.Multilayer 470pF 08051A471JAT2A SMD0805-MET
14 2 C53, C72 Cond.CRM.Multilayer 47nF C0805C473K5RAC SMD0805-MET
15 1 C58 Cond.CRM.Multilayer 330pF C0805C331J1GAC SMD0805-MET
16 2 C59, C60 Cond.CRM.Multilayer 56pF C0805C560J5GACT
U
| | SMD0805-
MET
17 2 C80, C81 Cond.Elt.Vert.
D=18MM

100uF EEUEE2D101S EV18
18 1 C88 Cond.CRM.Multilayer 100pF 08051A101JAT2A SMD0805-MET
19 1 C92 Cond.Elt.Vert. | 10uF ECA2CM100 EV10
20 0 C99, C106 Cond.Elt.Tantalio | D=10MM | 22uF T491B226K016AT ETANT-B-R
21 1 C126 Cond.CRM.Multilayer 330nF 08055C334KAT2A SMD0805- | solido
22 1 C137 Cond.ELT.Alluminio | 1000uF EEETK1H102AM ALLSIZEL | MET
23 31 DL2, DL3, DL4, DL5, | smd DIODO LED SMD GIALLO KP-2012YD LED0805-
DL6, DL7, DL8, DL9, DL10, DL11, DL12, | MET-1/2
DL13, DL14, DL15, DL16, DL17, DL18,
DL19, DL20, DL21, DL22, DL23, DL24,
DL32, DL38, DL39, DL40, DL41, DL42,
24 9 DL25, DL26, DL27, | DL45, DL46 DL28, DL29, DL30, | DIODO LED SMD VERDE KP-2012SGD LED0805- | MET-1/2
DL34, DL35, DL37, DL43, DL44
25 1 DL31 DIODO LED SMD ROSSO KP-2012ID LED0805- | MET-1/2
26 2 DL33, DL47 DIODO LED SMD BLU KP-2012PBC LED0805-27 1 DL36 DIODO LED SMD GIALLO KP-2012YD LED0805-28 1 DL48 DIODO LED SMD ARANCIO SML-211DTT86K LED0805-29 14 D1, D2, D5, D6, D8, | | D22, D23, D25, D26, D27, D28, | DIODO RETT.VELOCE ES1A ES1A SMA-1/2 | MET-1/2 MET-12 MET-1/2
| NOTA: COMPONENTI EVIDENZIATI IN ROSSO = NON MONTARE CC = COMPONENTE CRITICO, ATTENERSI ALLA LISTA MATERIALI | D29, D30, D77

NOTA: COMPONENTI EVIDENZIATI IN ROSSO = NON MONTARE | P.7.62 90° | 2,5/7-G-7,62 | 7.62-7
CC = COMPONENTE CRITICO, ATTENERSI ALLA LISTA MATERIALI

30 33 D9, D10, D11, D12,
D13, D14, D16,
D17, D18, D19,
D20, D21, D24,
D31, D34, D36,
D40, D41, D53,
D54, D55, D56,
D57, D58, D59,
D60, D61, D62,
D63, D64, D65,
D66, D67, D68,
D69, D70, D73,
D75, D76, D80, D81

DIODO SEGNALE 1N4148 1N4148WT SOD523F1-2 31 4 D32, D33, D35, D37 DIODO RETT.VELOCE RS1M-13-F RS1M-13-F SMA-1/2
32 7 D38, D39, D42, | DIODO RETT.VELOCE ES1B ES1B SMA-1/2
33 2 D44, D45 DIODO SEGNALE BAT754S BAT754S SOT23-123 34 2 D46, D47 DIODO RETT.VELOCE SK56C SK56C SMC-1/2 35 0 D52 DIODO RETT.VELOCE ES1G ES1G SMA-1/2 36 3 FL1, FL2, FL3 FILTRO EMI DC BNX002-01 BNX002-01 BNX002-01 37 1 FL4 FILTRO 38 2 F1, F2 FUSIBILE 39 2 F3, F4 FUSIBILE | D43, D48, D49, D50 | SOPPRESSIONE +PORTAFUSIBILE | NFM21PC47 4R1C3 5AT 0154005.DRT LITTLEFUSE-1AT 0154001.DRT LITTLEFUSE- | NFM21PC474R1C3 D | NFM21PC-0805 154
| JP12, JP13, JP14, JP15 | PIN PASSO 2.54 | 09-T-S-RA

+PORTAFUSIBILE

154
41 7 JP9, JP10, JP11,

HEADER DRITTO 2

TSW-102-

TSW-102-09-T-S-RA 2SIP100
42 1 J1 CONNETTORE 4 VIE | P.3.81 | MC 1.5/4 3.81 | 1803293 MC1.5-4-G- | 3.81
43 2 J2, J21 CONNETTORE 2 VIE | MC 1.5/2 | 1803277 MC1.5-2-G-
P.3.81 | 3.81 | 3.81
44 2 J3, J23 HEADER BOXED 2 X 3 | Spina 3x2 | 9185066324 SEK_0918506
PIN P.2.54 | ICD | X32X_HARTIN
45 2 J4, J5 CONNETTORE 20PIN | 9-338069-0 9-338069-0 TYCO-2- | G
46 1 J6 CONNETTORE 9 PIN | P.1.27 | MSTB 2,5/ | 1759088 MSTB2.5- | 338069-0
47 1 J7, J13 CONNETTORE 3 PIN | P.5.08 90° | 9-G-5,08 GMSTBA | 1766246 GMSTB2.5- | 5.08-9
48 1 J8, J17 CONN. DRITTO 3 PIN | P.7.62 90° | 2,5/ 3-G-7,62 MLSS-100-3 MLSS100-3 MLSS100-03 | 7.62-3
49 1 J9 CONNETTORE 7 PIN | PASSO 2.54 | GMSTBA | 1766288 GMSTB2.5-
LST05-190-3_assy01_r05 | 29.10.2018 | | | Pagina 4 di 12

73 4 P1, P5, P7, P9 TRIMMER MULTIGIRI | NOTA: COMPONENTI EVIDENZIATI IN ROSSO = NON MONTARE CC = COMPONENTE CRITICO, ATTENERSI ALLA LISTA MATERIALI | VERTICALE | 5K 3296W-1-502LF 3296W- | BOURNS

50 1 J10 CONN. DRITTO 2 PIN
PASSO 3.96

MASCON-
156

MLSS156-2 MLSS156-02
51 0 J11 CONNETTORE 4 PIN
P.7.62 90°

GMSTBA
2,5/ 4-G-
7,62

1766259 GMSTB2.5-
7.62-4
52 0 J12 CONN. 90° 3 PIN
PASSO 2.54

MLAS-3 MLAS156-3 MLAS156-03 53 1 J14 CONNETTRORE 4 VIE
P.3.81

MC 1.5/4
3.81

1803293 MC1.5-4-G-
3.81
54 2 J15, J16 CONN. 2 X 5 P.2MM
DRITTO

98414-G06-
10ULF

98414-G06-10ULF FCI-98414-G-
06-10
55 0 J18 CONN. DRITTO 2 PIN
PASSO 2.54

MLSS-100-2 MLSS100-2 MLSS100-02 56 0 J19 CONN. 90° 2 X 5
PASSO 3 MM | 794618-0

4-794618-0 4-794618-0 TYCO-4-
57 0 J20 CONN. DRITTO 2 X 5 | P.127 | 1-338068-0 1-338068-0 TYCO-1- | 338068-0
58 1 J22 CONN. AMPMODU II 59 1 J24 PRED.NE PER XR2206 | 6 X 2 DRITTO | 5-103168-1 5-103168-1 5-103168-1-NON | TYCO 5SIP100
60 1 J25 TERMINALE DRITTO | EXT | MONTARE
61 8 K1, K2, K3, K5, K6, | FASTON 6.35 X 0.84 63849-1 TE FAS1 RELE' STATO SOLIDO | CPC1017NT | CPC1017NTR CPC1017N-
62 1 K4 RELE' STATO SOLIDO | K7, K8, K9 | SMD | R CPC1918 CPC1918 CPC1918- | CLARE
63 3 K10, K11, K12 RELE' 12V 6A | PTH | SPDT-6A 32.21.7.012.2000 32.21- | CLARE+DISS
64 2 OC1, OC2 OPTOISOLATORE | DOPPIO | TCMT4100 TCMT4100 MINIFLAT16 | FINDER
65 11 OC3, OC6, OC8, | QUADRUPLO OPTOISOLATORE | TCMT1103 TCMT1103 MINIFLAT4
OC10, OC18, OC19, OC20, OC21, OC22, | SINGOLO
66 1 OC11 OPTOISOLATORE | OC23, OC29, OC30 | TCMT4106 TCMT4106 MINIFLAT16
67 1 OC12, OC17 OPTOISOLATORE | QUADRUPLO | MOC3063SR | MOC3063SR2M PSMD6
68 0 OC13, OC14, OC15, | SINGOLO OPTOISOLATORE | 2M FODM3053 FODM3053R2V_NF | MFP4
69 1 PCB1 MODULO | OC16 | SINGOLO | PCB-11-219 PCB-11-219-1 PCB-11-219 | 098
70 2 PD1, PD2 PONTE DIODI PTH GBU6-03 GBU603 GBU6H | METALTRONICA
71 2 PD3, PD4 PONTE DIODI SMD DF01S DF01S DF01S 72 1 PD5 PONTE DIODI SMD MB4S MB4S-E3/45 TO269AA
LST05-190-3_assy01_r05 | 29.10.2018 | Pagina 5 di 12

NOTA: COMPONENTI EVIDENZIATI IN ROSSO = NON MONTARE CC = COMPONENTE CRITICO, ATTENERSI ALLA LISTA MATERIALI
LST05-190-3_assy01_r05 29.10.2018 Pagina 6 di 12

74 3 P2, P3, P11 TRIMMER MULTIGIRI
VERTICALE

100K 3296W-1-104LF 3296W-
BOURNS
75 1 P4 TRIMMER MULTIGIRI
VERTICALE

10K 3296W-1-103LF 3296W-
BOURNS
76 2 P6, P8 TRIMMER MULTIGIRI
VERTICALE

20K 3296W-1-203LF 3296W-
BOURNS
77 1 P10 TRIMMER MULTIGIRI
VERTICALE

20R 3296W-1-200LF 3296W-
BOURNS
78 4 Q4, Q8, Q9, Q27,
Q29

MOSFET CANALE N
100V 0.85A

BSH114 BSH114 SOT23-123
79 2 Q34, Q35 MOSFET CANALE N
60V 1.3A

ZXMS6004F
FTA
(Mouser:
522-
ZXMS6004F
80 4 Q5, Q6, Q25, Q28 TRANSISTOR NPN | FTA) BC847BW BC847BW SOT323_123

ZXMS6004FFTA
(Mouser: 522-
ZXMS6004FFTA)

SOT23-123

81 1 Q7 TRANSISTOR NPN | 45V 0.1A | BC857BW BC857BW SOT323_123
82 9 Q10, Q11, Q12, | 45V 0.1A MOSFET CANALE N | BSS138K BSS138K SOT23-123
Q13, Q14, Q15, Q17, Q19, Q20, | 50V 0.2A
| Q22, Q24, Q26, Q30, Q31, Q32,
86 32 R3, R4, R5, R8, R48, | | FILM 1/8W 1% RESISTORE THICK | 1K CRCW08051K00FKE | A | MET SMD0805-
83 0 Q16, Q18, Q21, 84 1 R1 RESISTORE THICK 85 1 R2 RESISTORE THICK | Q33 Q23 | FILM 1/8W 1% | BTA16-BW (no snub) 270R CRG0805F270R SMD0805-3K CRCW08053K00FKE | BTA16-600BWRG TO220AB | MET SMD0805-
| R74, R89, R103, R109, R115, R121, | FILM 1/8W 1% | | A | MET
R122, R123, R128,
R132, R151, R158,
R229, R230, R236,
R245, R247, R249,
R251, R270, R271,
R276, R278, R279,
R280, R281, R290

96 4 R76, R157, R164, 97 1 R77 RESISTORE THICK 98 13 R79, R95, R102, | NOTA: COMPONENTI EVIDENZIATI IN ROSSO = NON MONTARE | R336 R106, R211, R213, R215, R220, R221, R223, R227, R252, R273 | RESISTORE THICK FILM 1/8W 1% FILM 1/4W 1% RESISTORE THICK FILM 1/8W 1% | 2K CRCW08052K00FKE 1K5 CRCW12061K50FKE 33K CRCW080533K0FKE | A A A | SMD0805-MET SMD1206 SMD0805-MET
CC = COMPONENTE CRITICO, ATTENERSI ALLA LISTA MATERIALI
LST05-190-3_assy01_r05 | 29.10.2018 | Pagina 7 di 12

87 24 R6, R13, R15, R84,
R114, R139, R142,
R146, R147, R161,
R169, R173, R176,
R181, R182, R201,
R203, R206, R208,
R219, R222, R225,
R238, R239, R286,
R343, R355, R356

RESISTORE THICK
FILM 1/8W 1%
| 10K CRCW080510K0FKE
A
| | SMD0805-
MET
88 5 R7, R44, R45, R126,
R136

RESISTORE THICK
FILM 1/8W 1%
| 6K8 CRCW08056K80FKE
A
| | SMD0805-
MET
89 3 R9, R129, R133,
R202, R204, R205,
R207, R209, R210

RESISTORE THICK
FILM 1/8W 1%
| 100K CRCW0805100KFKE
A
| | SMD0805-
MET
90 19 R10, R25, R26, R27, | RESISTORE THICK | 4K7 PANERJ6ENF4701V SMD0805-
91 9 R14, R17, R18, R19, | R28, R29, R31, R78, R82, R93, R97, R112, R150, R159, R232, R254, R269, R274, R341, R342 R20, R21, R23, | FILM 1/8W 1% RESISTORE THICK FILM 1/8W 1% | 390R CRCW0805390RFKE | A | MET SMD0805-MET
93 37 R40, R41, R42, R43, | | 2W RESISTORE THICK | 2K2 PANERJ6ENF2201V SMD0805-

R105, R111, R130
92 1 R16

10R SMW210RJT SM2-TYCO
| R47, R50, R51, R52, R53, R54, R55, R56, R57, R58, R59, R60, R61, R62, R63, R64, | FILM 1/8W 1% | | | MET
95 3 R75, R119, R144 RESISTORE THICK | R104, R118, R131, R134 | FILM 1/8W 1% | 220R CRG0805F220R SMD0805- | A | MET

R65, R66, R67, R68, R69, R70, R71, R73, R80, R88, R96,

| FILM 1/8W 1% | MET

R231, R235, R261,
R291, R302, R310
94 7 R46, R49, R72,

RESISTORE THICK

3K3 CRCW08053K30FKE

SMD0805-

NOTA: COMPONENTI EVIDENZIATI IN ROSSO = NON MONTARE CC = COMPONENTE CRITICO, ATTENERSI ALLA LISTA MATERIALI | FILM 1/8W 1% | A | MET

99 1 R81 RESISTORE THICK
FILM 1/4W 1%

18K CRCW120618K0FKE
A

SMD1206
100 4 R83, R113, R141,
R216

RESISTORE THICK
FILM 1/8W 1%

18K CRCW080518K0FKE
A

SMD0805-
MET
101 8 R85, R86, R87, R90,
R91, R92, R94,
R170

RESISTORE THICK
FILM 1/4W 1%

130K CRCW1206130KFKE
A

SMD1206
102 14 R98, R145, R148,
R149, R152, R155,
R165, R166, R167,
R179, R189, R191,
R196, R199, R244,
R246, R248, R250

RESISTORE THICK
FILM 1/8W 1%

5K6 CRCW08055K60FKE
A

SMD0805-
MET
103 1 R99 RESISTORE THICK
FILM 1/8W 1% | A | MET

4K32 CRCW08054K32FKE

SMD0805-
104 16 R100, R255, R262, | R272, R282, R284, | RESISTORE THICK FILM 1/8W 1% | 470R CRCW0805470RFKE | A | SMD0805-MET
R345, R346, R347, R348, R349, R350, R351, R352, R353,
105 2 R101, R171 RESISTORE THICK | R354 | FILM 1/8W 1% | 1K2 CRCW08051K20FKE | A | SMD0805-MET
109 1 R117 RESISTORE THICK | | FILM 1/8W 1% | 120K CRCW0805120KFKE | 10R0GLF | MET SMD0805-
113 2 R135, R162 RESISTORE THICK | | FILM 1/8W 1% | 12K CPF0805B12KE1 SMD0805- | | MET
106 4 R107, R108, R160, 107 1 R110 RESISTORE THICK 108 1 R116 RESISTORE THICK | R163 | RESISTORE THICK FILM 1/8W 1% FILM 1/8W 1% | 56K CRCW080556K0FKE 8K45 CRCW08058K45FKE 10R CR0805-FX- | A A | SMD0805-MET SMD0805-MET SMD0805-
110 2 R120, R358 RESISTORE THICK 111 1 R124 RESISTORE THICK 112 3 R125, R237, R287 RESISTORE THICK | FILM 1/8W 1% FILM 1/8W 1% FILM 1/4W 1% | 15R CRG0805F15R SMD0805-82R CRCW120682R0FKE 100R PHY232273461001 SMD0805- | A AHP | MET MET SMD1206
115 1 R138 RESISTORE THICK | FILM 1/8W 1% | 16K5 MCTC0525B1652T5 | A | MET SMD0805-
114 1 R137 RESISTORE THICK | FILM 1/8W 1% | 47R CRCW080547R0FKE | MET SMD0805-
116 3 R140, R172, R212 RESISTORE THICK | FILM 1/8W 1% | 39K CRCW080539K0FKE | E | MET SMD0805-
117 3 R143, R214, R228 RESISTORE THICK | FILM 1/8W 1% | 27K CRCW080527K0FKE | A | MET SMD0805-
LST05-190-3_assy01_r05 | 29.10.2018 | | | Pagina 8 di 12
118 2 R153, R154 RESISTORE THICK | FILM 1/8W 1% | 200R CRCW0805200RFKE | A | MET SMD0805-

119 6 R156, R174, R175,
R177, R178, R180,
R185, R186, R187,
R193, R197

RESISTORE THICK
FILM 1/8W 1%

820R PANERJ6GEYJ821V SMD0805-MET
120 1 R168 RESISTORE THICK
FILM 1/4W 1%

15K CRCW120615K0FKE
AHP

SMD1206
121 0 R183 RESISTORE THICK
FILM 1/4W 1%

430K CRCW0805430KFKE
A

SMD0805-
MET
122 0 R184 RESISTORE THICK
FILM 1/8W 1%

1K CR1206-FX-1001ELF SMD1206
123 0 R188, R190, R194,
R195, R198, R200

RESISTORE THICK
FILM 1/4W 1%

100R CRCW1206100RFKE
AHP

SMD1206
124 0 R192 RESISTORE THICK
FILM 1/4W 1%

47R CRCW120647R0FKE
A

SMD1206
125 2 R217, R344 RESISTORE THICK | 47K CRCW080547K0FKE | SMD0805-
126 3 R218, R233, R234, 127 2 R224, R243 RESISTORE THICK | R357, R127 | FILM 1/8W 1% RESISTORE THICK FILM 1/8W 1% | 2K7 CRCW08052K70FKE 20K CRCW080520K0FKE | A A | MET SMD0805-MET SMD0805-
128 1 R226 RESISTORE THICK | FILM 1/8W 1% | 8K2 CRCW08058K20FKE | A | MET SMD0805-
129 2 R241, R242 RESISTORE THICK | FILM 1/8W 1% | 220K CRCW1206220KFKE | A | MET SMD1206
130 4 R257, R258, R259, | FILM 1/4W 1% RESISTORE THICK | 249R CRCW1206249RFKE | A | SMD1206
131 1 R275 RESISTORE THICK | R260 | FILM 1/4W 1% | 560R CRCW0805560RFKE | A | SMD0805-
132 1 R283 RESISTORE THICK | FILM 1/8W 1% | 120R CRCW0805120RFKE | A | MET SMD0805-
133 2 R285, R288 RESISTORE THICK | FILM 1/8W 1% | 1R ERJ6RQF1R0V SMD0805- | A | MET
134 1 R289 RESISTORE THICK | FILM 1/8W 1% | 330R Vari SMD0805- | MET
135 1 R338 RESISTORE THICK | FILM 1/8W 1% | 0R CRCW08050000ZST | MET SMD0805-
136 1 R339, R340, R240 RESISTORE THICK | FILM 1/8W 1% | 10K PANERJ6GEYJ103V SMD0805- | A | MET
140 1 TH2 FUSIBILE | RIPRISTINABILE | 100mA MICROSMD010F MICROSMD0 | | CO
137 1 TF1 TRASFORMATORE | FILM 1/8W 1% | TF108 TF108-MEDEL TF108- | MET
138 1 TF2 TRASFORMATORE | | | METALTRONICA | TF208 TF208-MEDEL TF208- | MEDEL-C
| NOTA: COMPONENTI EVIDENZIATI IN ROSSO = NON MONTARE CC = COMPONENTE CRITICO, ATTENERSI ALLA LISTA MATERIALI | TP6, TP7 | PCB 1MM | | MM

METALTRONICA

MEDEL+5MM
139 3 TH1, TH3, TH4 FUSIBILE

500mA,60V SMD050F-2 SMD050F_TY
141 6 TP1, TP3, TP4, TP5, | RIPRISTINABILE TEST POINT FORO SU | ROSSO RS200-207 TESTPOINT_1 | 10F
LST05-190-3_assy01_r05 | 29.10.2018 | | Pagina 9 di 12

142 2 TP2, TP13 TEST POINT FORO SU
PCB 1MM

NERO RS200-203 TESTPOINT_1 MM
143 2 TP8, TP11 TEST POINT FORO SU
PCB 1MM

BIANCO RS200-201 TESTPOINT_1 MM
144 17 TP9, TP10, TP12,
TP14, TP16, TP17,
TP18, TP20, TP21,
TP22, TP25, TP29,
TP33, TP34, TP37,
TP38, TP39

TEST POINT FORO SU
PCB 1MM

GIALLO RS200-202 TESTPOINT_1 MM
145 2 TP31, TP36 TEST POINT FORO SU
PCB 1MM

VERDE RS200-208 TESTPOINT_1 MM
146 1 U1 REG. TENSIONE 12 V

### 1 A

R-78C12-1.0 R-78C12-1.0 R-78CXX-1.0-
RECOM
147 1 U2 REG. TENSIONE 5 V | RECOM- | R-785.0-0.5 R-78XX-0.5-
148 1 U3 REG. TENSIONE NEG | 0.5A | 7805 LM7912 LM7912CT TO220RV | RECOM
149 2 U4, U30 REG. TENSIONE ADJ LM317A LM317AEMP/NOPB SOT223-1234 | 12 V 1 A
153 2 U8, U11 CIRCUITO | E | CD4555B CD4555BM SOG.050/16/ | 4/WG12.00
150 1 U5 REG. TENSIONE 15 V 151 1 U6 CIRCUITO 152 1 U7 MICROCONTROLLOR | 1 A INTEGRATO | R-78C15-1.0 R-78C15-1.0 R-78CXX-1.0-SN74LVC13 8AD PIC16F877A PIC16F877A-I/PT QUAD.80M/4 | SN74LVC138ADRG4 SOG.050/16/ | RECOM WG.244/L.39 4
154 2 U9, U10 CIRCUITO | INTEGRATO | MCP23S17 MCP23S17-E/SS SOG.65M/28/ | | WG8.20/L10.
INTEGRATO | WG.244/L.39 4
155 1 U12 CIRCUITO | CD4023BPW CD4023BPW PW-14 TEXAS | 80
INTEGRATO
156 1 U19 CIRCUITO | INTEGRATO | NE555DT NE555DT SO8
157 1 U20 CIRCUITO 158 3 U21, U22, U26 CIRCUITO | | INTEGRATO | CD4013B CD4013BPWR PW-14 TEXAS UCC27525D | UCC27525DSDT SON65P300X
161 4 U25, U28, U44, 162 1 U29 CIRCUITO | U54 | CIRCUITO INTEGRATO | IL300-DEFG-X007 UC3841DW | IL300-DEFG-X007 SMD-8 UC3841DW oppure | SOG.050/18/
LST05-190-3_assy01_r05 | | 29.10.2018 | | Pagina 10 di 12
159 2 U23, U36 CIRCUITO | | INTEGRATO | SD DAC8512FSZ DAC8512FSZ SO8 | | 300X80-9N
| NOTA: COMPONENTI EVIDENZIATI IN ROSSO = NON MONTARE CC = COMPONENTE CRITICO, ATTENERSI ALLA LISTA MATERIALI | INTEGRATO | oppure UC2841DW | UC2841DW | WG.420/L.46 2
160 5 U24, U27, U31, | U34, U43 | INTEGRATO CIRCUITO INTEGRATO | LM358ADGK RG4 | LM358ADGKRG4 SOG.65M/8/ | WG5/L3.1

NOTA: COMPONENTI EVIDENZIATI IN ROSSO = NON MONTARE CC = COMPONENTE CRITICO, ATTENERSI ALLA LISTA MATERIALI

163 1 U32 CIRCUITO
INTEGRATO

LM331N/NO
PB

LM331N/NOPB B8
164 1 U35 CIRCUITO
INTEGRATO

LM1458M LM1458M SO8
165 1 U37 CIRCUITO
INTEGRATO

XR2206CP XR2206CP B16
166 1 U38 CIRCUITO
INTEGRATO

LR8N8-G LR8N8-G SOT89_123
167 0 U39, U40 CIRCUITO
INTEGRATO

LM324PT LM324PT SOG.65M/14/
WG6.4/L5.00
168 0 U41, U42 CIRCUITO
INTEGRATO

ACS712ELCT
R-05B-T

ACS712ELCTR-05B-
T

SO8
169 1 U45 CIRCUITO
INTEGRATO

MCP6S28-
I/SL

MCP6S28-I/SL SO16
170 2 U46, U47 CIRCUITO | SN75HVD30 | SN75HVD3082EDG | SO8
171 0 U48 CIRCUITO | INTEGRATO | 82EDG4 MAX6661AE | 4 MAX6661AEE SOG.025/16/
INTEGRATO | E | WG.244/L.19 6
172 0 U49 CIRCUITO | INTEGRATO | L78L05ACUT R | L78L05ACUTR SOT89_123
173 0 U50 CIRCUITO | INTEGRATO | ADUM2200 BRWZ | ADUM2200BRWZ SOG.050/16/ | WG.420/L.41
174 0 U51 CIRCUITO | SN65LVDS9 | SN65LVDS9638DGK | 2 SOG.65M/8/
175 2 U52, U61 CIRCUITO | INTEGRATO | 638DGKR LM317AEM | R LM317AEMP/NOPB SOT223-1234 | WG5/L3.1
176 1 U55 CIRCUITO | INTEGRATO | P/NOPB MCP6S22- | MCP6S22-I/MS SOG.65M/8/
177 0 U56, U57, U58, | INTEGRATO CIRCUITO | I/MS SN65HVD30 | SN65HVD3085EDG | WG4.9/L3.00 SOG.65M/8/
178 1 U60 MICROCONTROLLOR | U59 | INTEGRATO E | 85EDGK PIC16F876A -I/SS | K PIC16F876A-I/SS SOG.65M/28/ | WG5/L3.1 WG8.20/L10.
181 1 V4 VARISTORE V33MLA120 | | | 6H | V33MLA1206H SMD1206
179 1 U62 DC/DC OPTOISOLATO | TMA1515S TMA1515S TMHXXXXS- | 80
180 1 V1 VARISTORE V18MLA121 | 15/15V | 0H | V18MLA1210H SMD1210 | TRACO
182 0 X1 QUARZO SMDB3 SMDB3 SOT23-123 183 1 Y1 QUARZO 3.6864MHz 9C-3.6864MAAJ-T HC49SMD 184 1 Y2 QUARZO 16MHZ 7A-16.000MAAJ-T TA-5X3.2-TXC 185
186 | 1 | DISSIPATORE PER PCB 11-219-XX | MQ11194-01 METALTRONICA
LST05-190-3_assy01_r05 | | 29.10.2018 | | Pagina 11 di 12

1

THERMAL-GAP
DENKA FSL400B 35mm x 60mm VEDI NOTA 2

NOTA: COMPONENTI EVIDENZIATI IN ROSSO = NON MONTARE CC = COMPONENTE CRITICO, ATTENERSI ALLA LISTA MATERIALI
LST05-190-3_assy01_r05 29.10.2018 Pagina 12 di 12

187
8
DISTANZIALI NYLON

ESSENTRA
SRS4-5-01 H=7.9 mm VEDI NOTA 3

188
3
VITE VTSTC

M3 X 16
INOX

X FISSAGGIO
MODULO VEDI NOTA 4

189
5
DADI M3 INOX

VEDI NOTA
4,5

190
5

ROSETTA
ELASTICA INOX Øi

### 3.2 mm

VEDI NOTA
4,5

191
QB

THERMAL PAD
DENKA

FSL100B
(1MM) VEDI NOTA 5

198
2
VITE VTCEI

M3 X 10
INOX VEDI NOTA 5

199
1

CIRCUITO
STAMPATO CS/05-190-3

METALTRON
ICA

NOTE

### 1 UTILIZZARE ULTIMA REVISIONE RILASCIATA 2 INTERPOSTO TRA PCB1 E POS.184 3 INSERITI NEI FORI FISSAGGIO SCHEDA 4 UTILIZZATI PER FISSAGGIO PCB1 5 UTILIZZATI PER FISSAGGIO PD1/PD2
