marcorispoli/PCB-26-349/ORCAD/Architecture.png

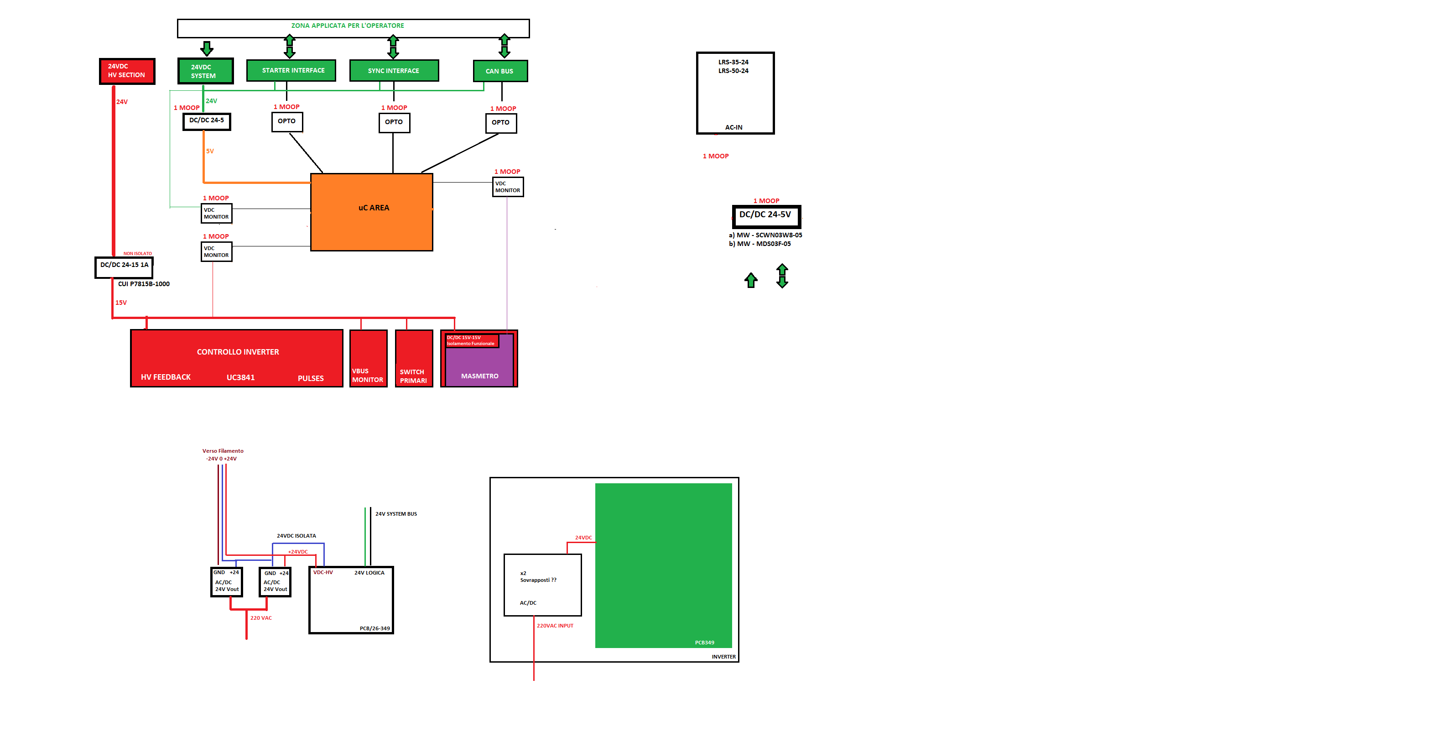
ORCAD/Architecture.png
