marcorispoli/PCB-26-349/ORCAD/Layout.png

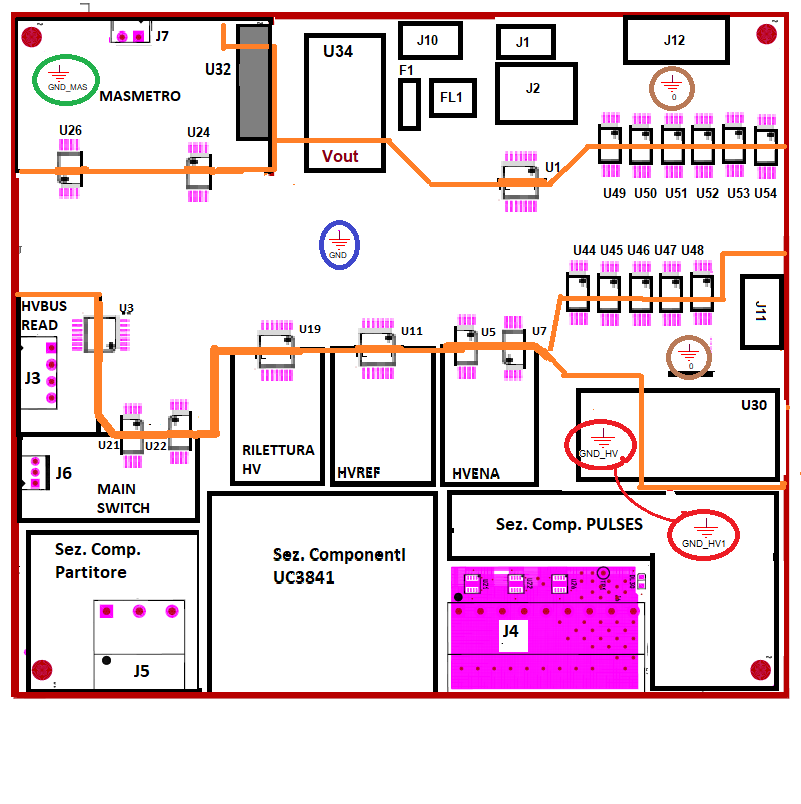
ORCAD/Layout.png
