marcorispoli/PCB-26-349/ORCAD/Piazzamento_PCB349.dxf

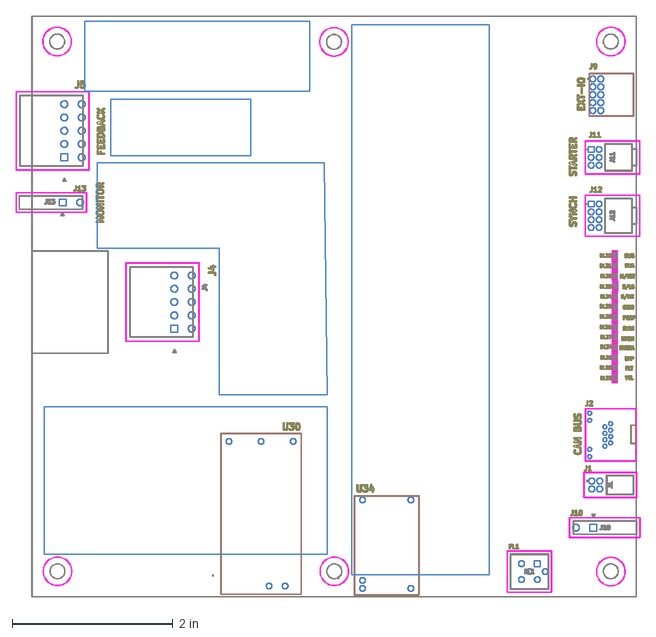
[picture p5: CAD file, 2026-08-03]
ORCAD/Piazzamento_PCB349.dxf
7.76 x 7.22 in
