marcorispoli/PCB-26-349/(list of files, cad)

Other CAD files:
ESECUTIVI/PF26-349-0.dwg
ORCAD/26-349-0.dwg
ESECUTIVI/PM26-349-0.dwg
