marcorispoli/PCB-26-349/ORCAD/SE26-349-0.pdf

0

100nF

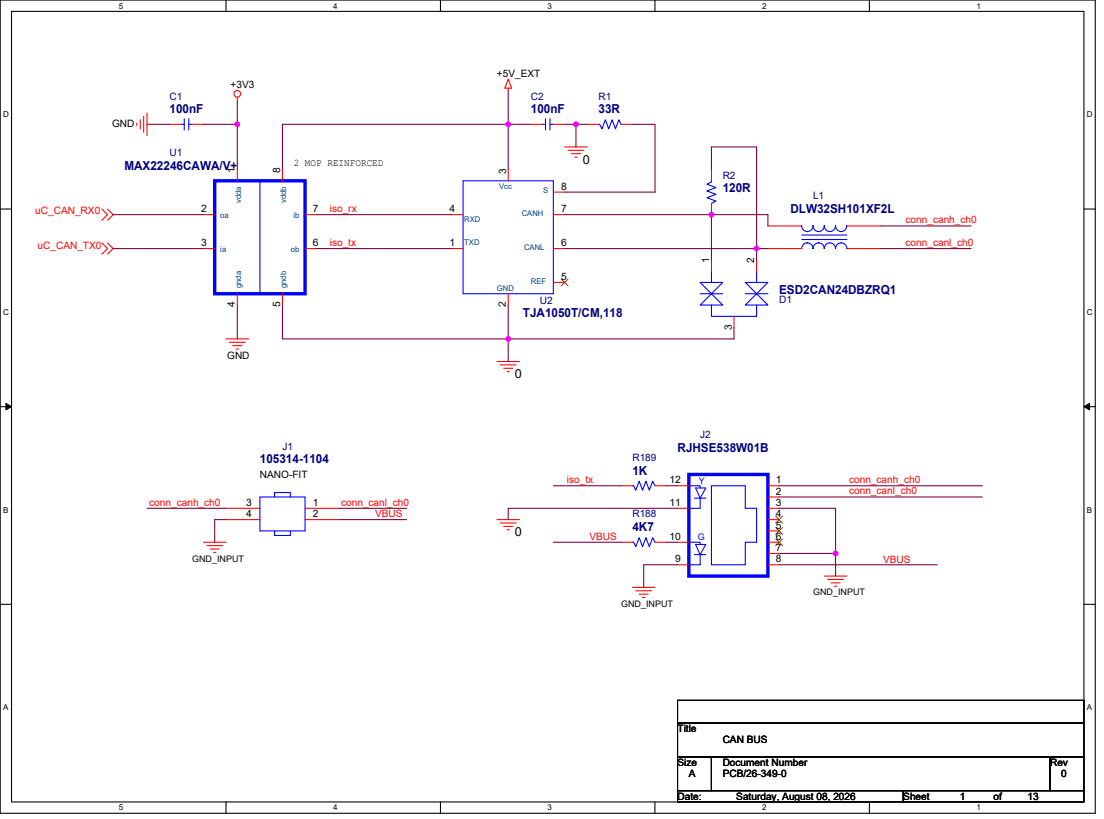
[picture p6: page 1]

Size A | Document Number PCB/26-349-0 | Rev 0

Date: Saturday, August 08, 2026 Saturday, August 08, 2026 Saturday, August 08, 2026 | Sheet 1 1 1 of 13 13 13

0
120R

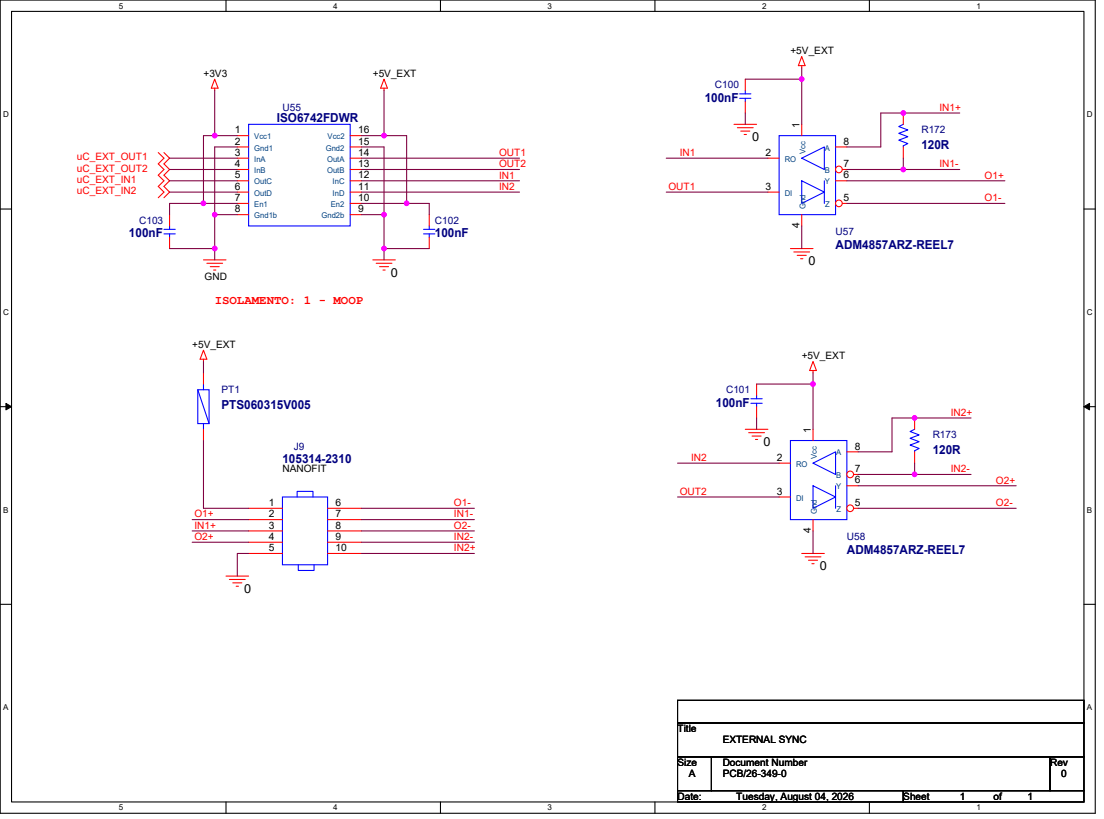
[picture p7: page 2]

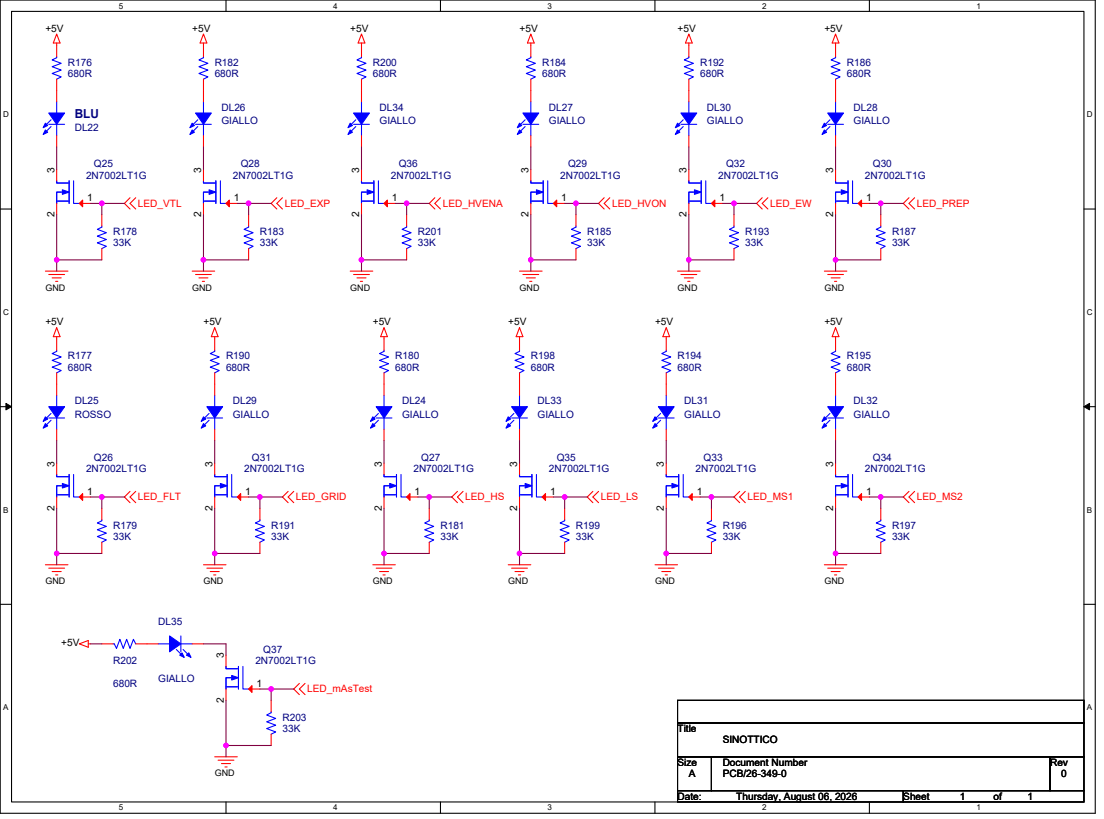
[picture p8: page 3]

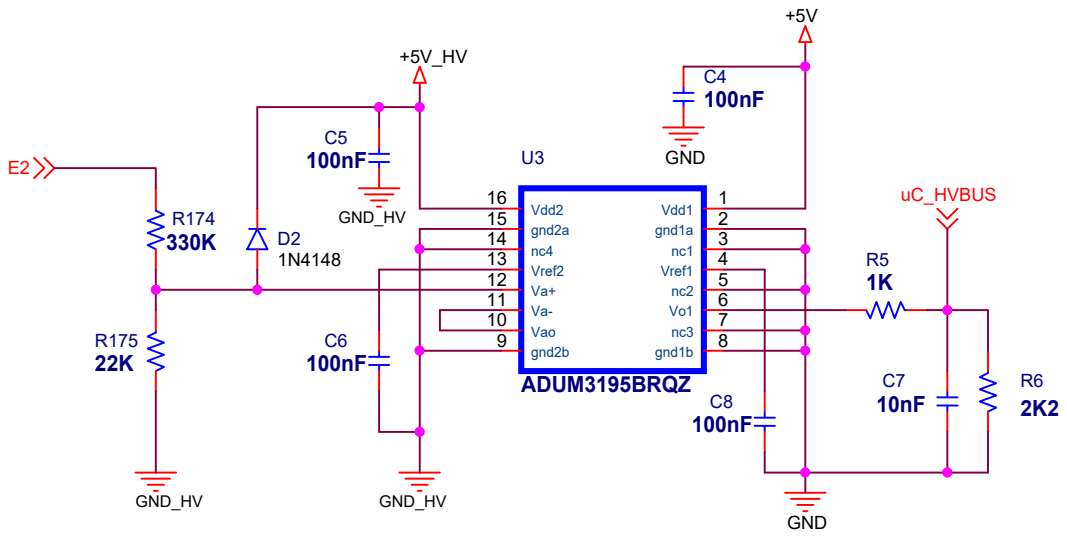
[picture p9: page 4]

D | D

## ATTIVAZIONE SEGNALE HVENA

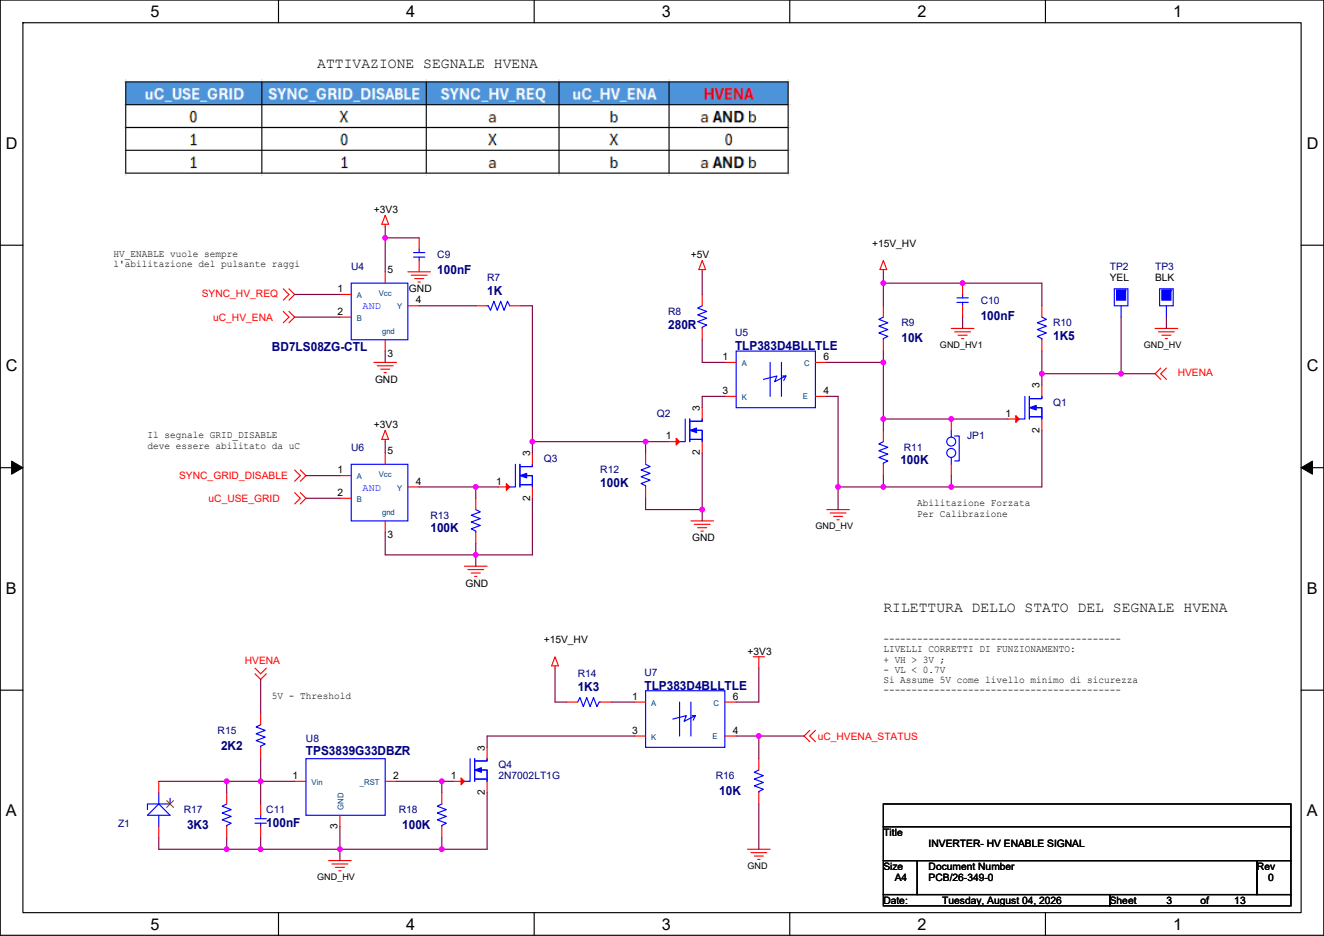
[picture p10: page 5]

HV_ENABLE vuole sempre
l'abilitazione del pulsante raggi

Il segnale GRID_DISABLE
deve essere abilitato da uC

RILETTURA DELLO STATO DEL SEGNALE HVENA

LIVELLI CORRETTI DI FUNZIONAMENTO:
Si Assume 5V come livello minimo di sicurezza

INVERTER- HV ENABLE SIGNAL

Tuesday, August 04, 2026 Tuesday, August 04, 2026 Tuesday, August 04, 2026 | 3 3 3 13 13 13

# Segnale Isolato di riferimento per regolazione tensione HV

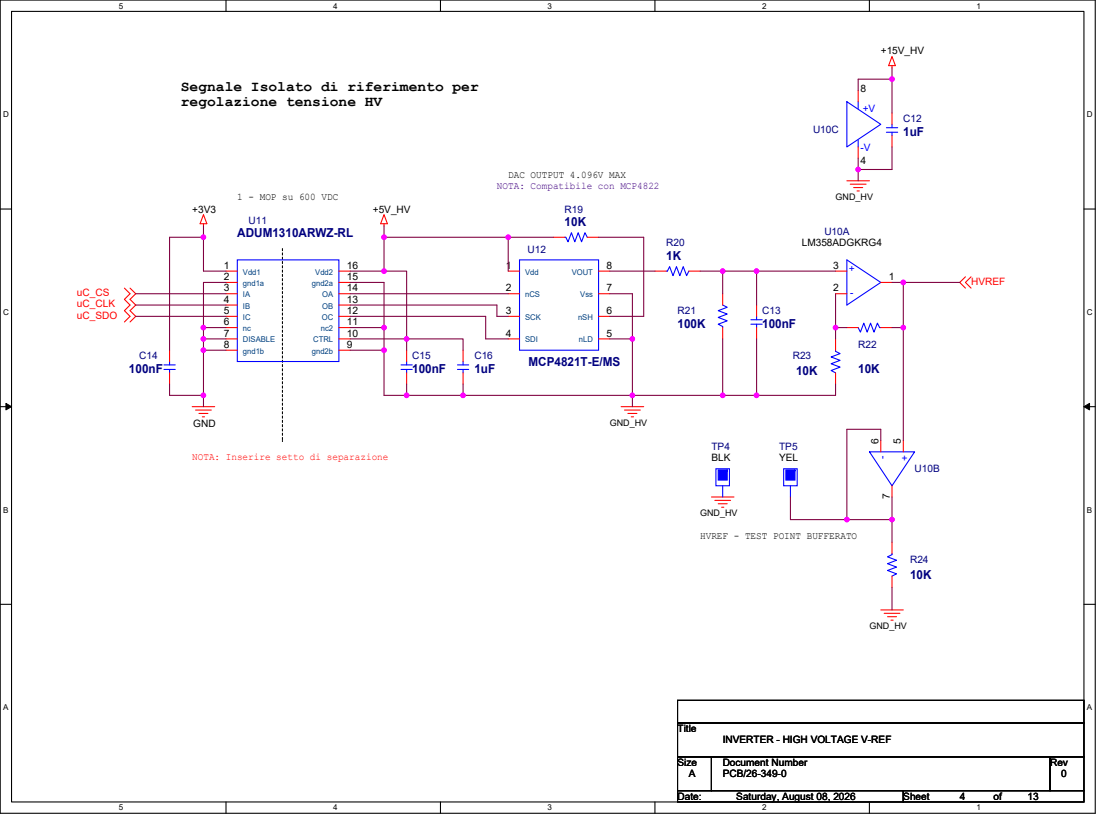
[picture p11: page 6]

NOTA: Inserire setto di separazione

HVREF - TEST POINT BUFFERATO

INVERTER - HIGH VOLTAGE V-REF

# 100KHz Oscillatore onda quadra

# NON USATO

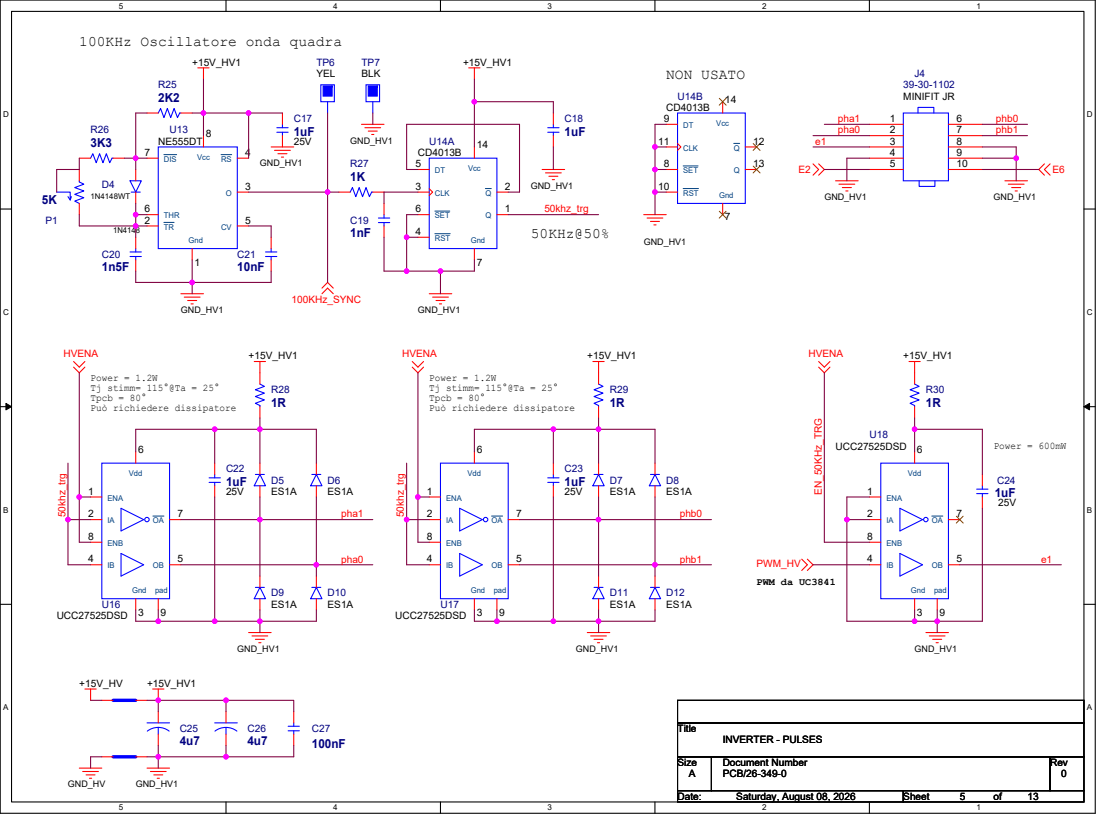
[picture p12: page 7]

D | D

## SEZIONE FEEDBACK DI TENSIONE HV

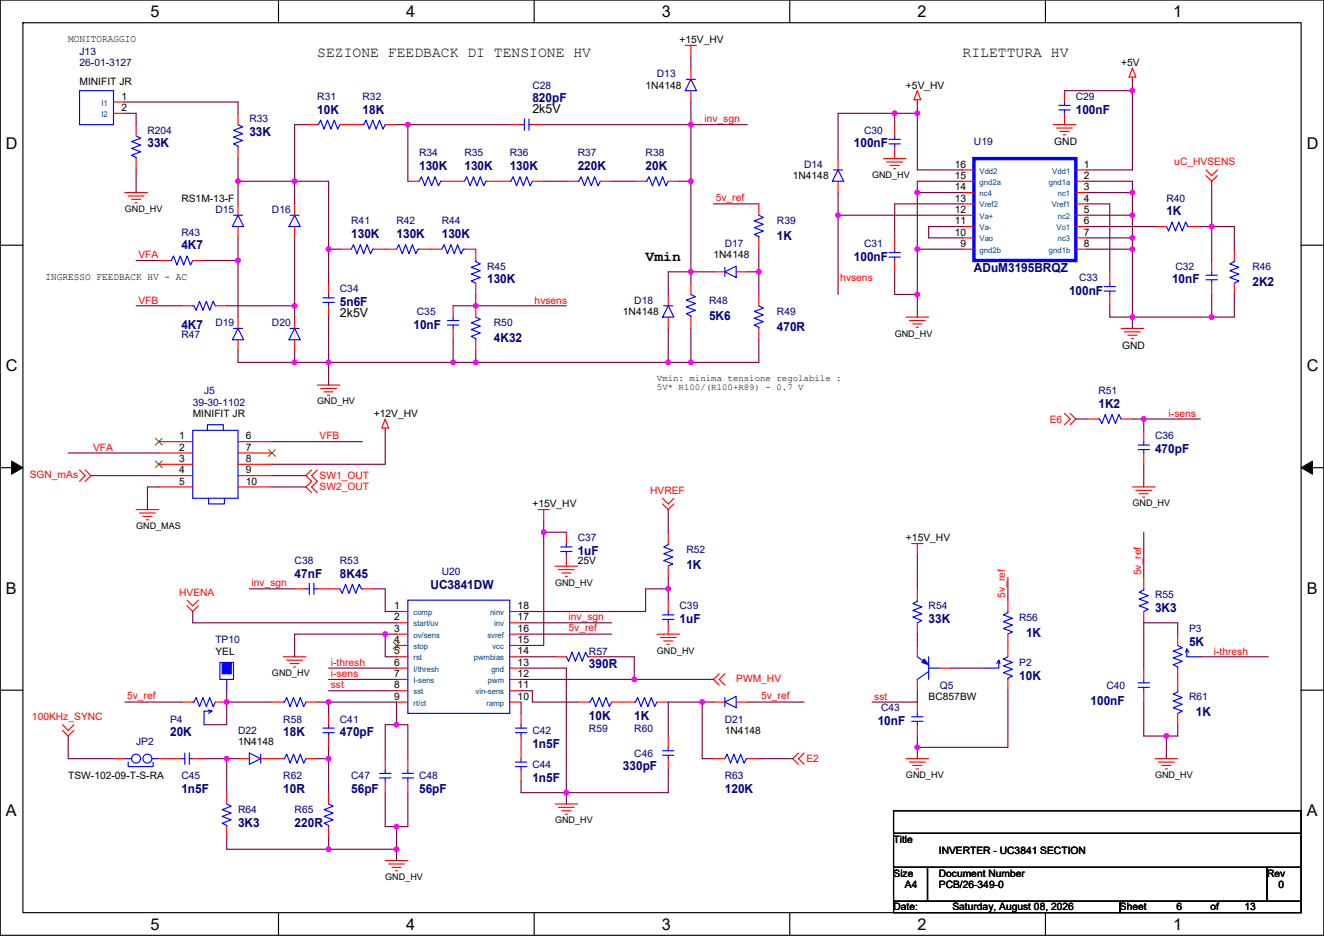
[picture p13: page 8]

INGRESSO FEEDBACK HV - AC

Vmin: minima tensione regolabile :

22uF

280R

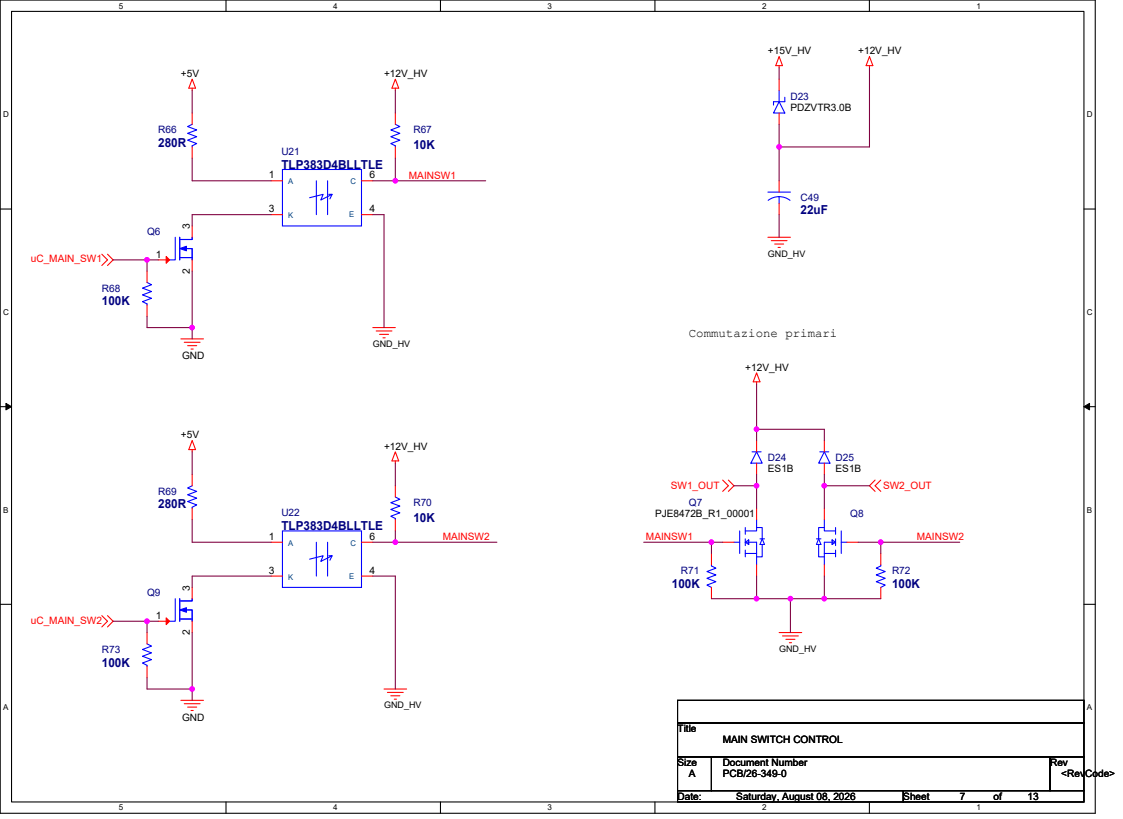
[picture p14: page 9]

D | D

### 250mA -> 25KHz

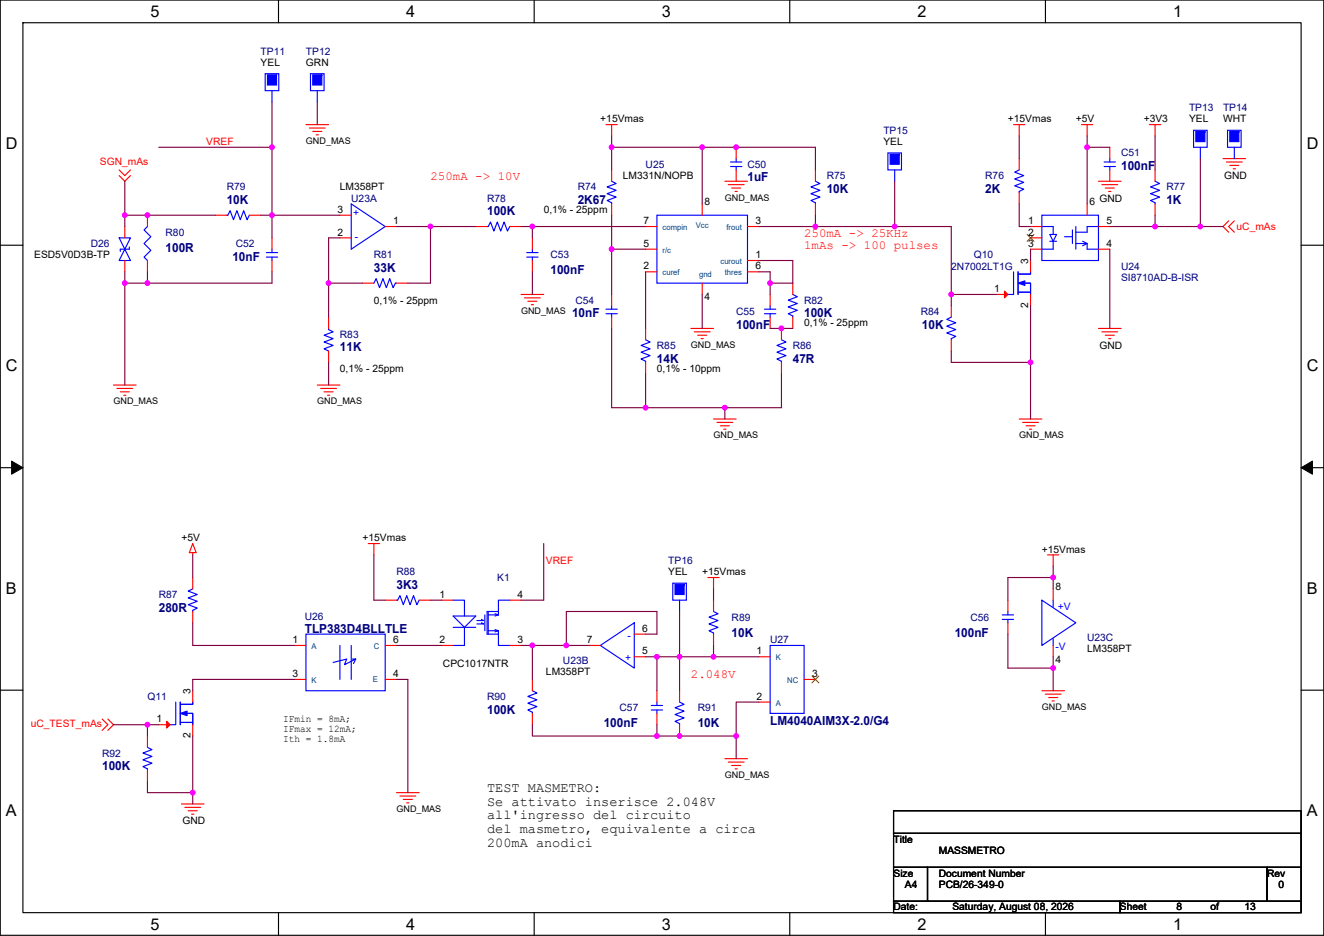
[picture p15: page 10]

TEST MASMETRO:
Se attivato inserisce 2.048V
all'ingresso del circuito
del masmetro, equivalente a circa
200mA anodici

D | D

### BLM18BD102

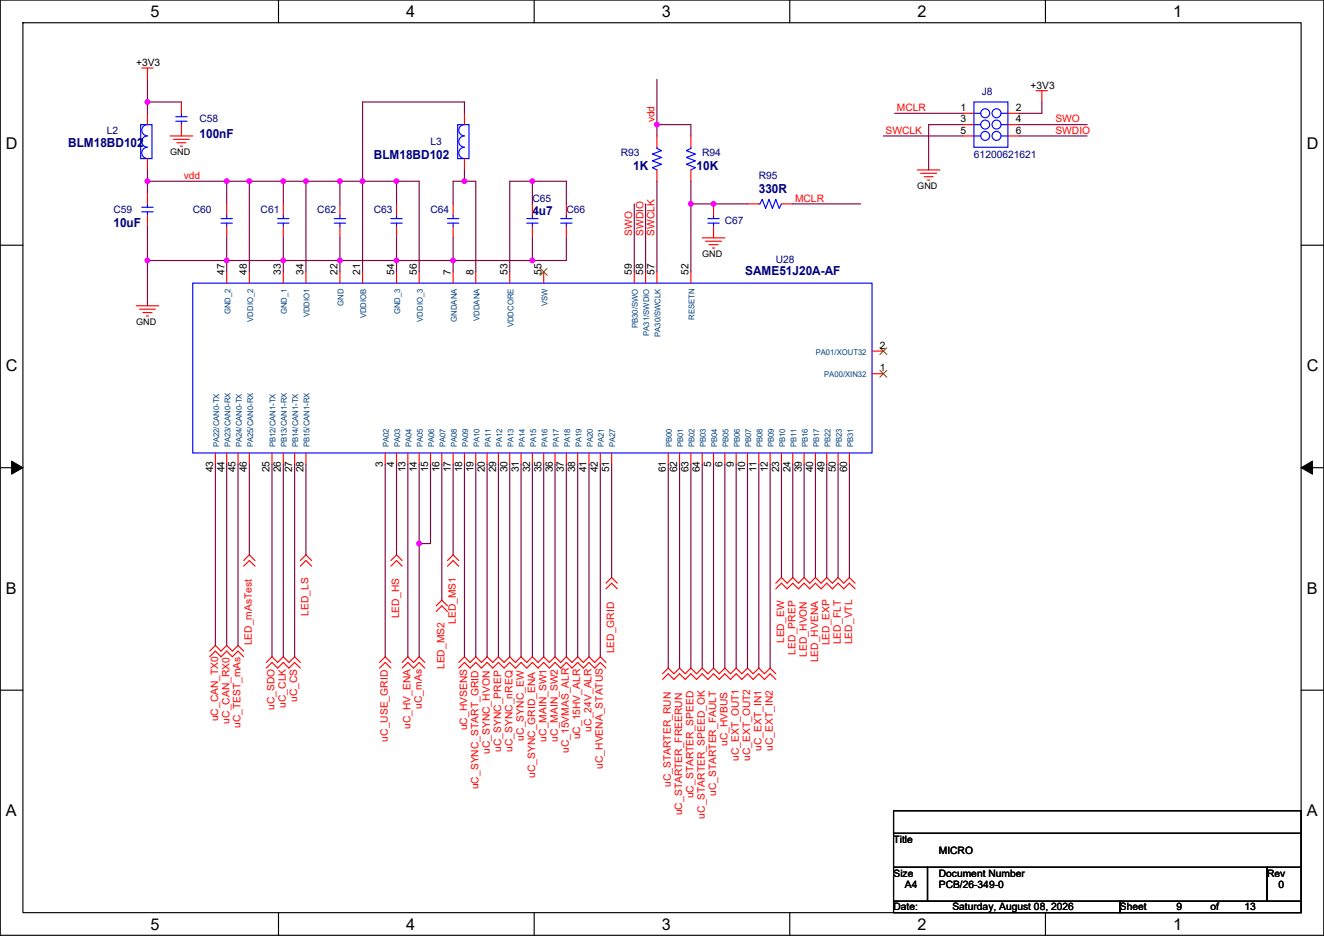
[picture p16: page 11]

D | D

## INPUT POWER E FILTRO EMI

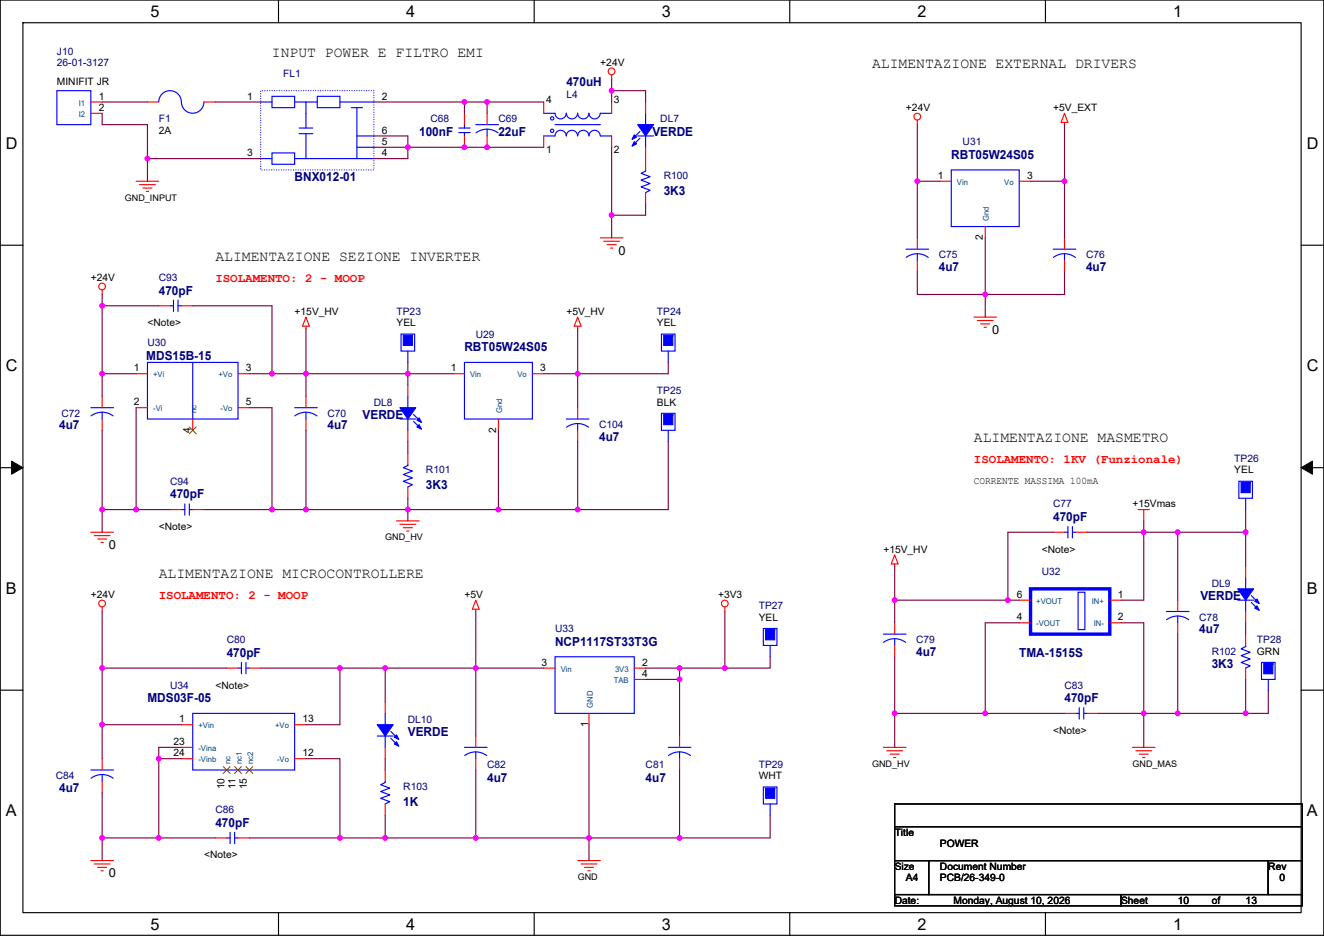
[picture p17: page 12]

D | D
12K

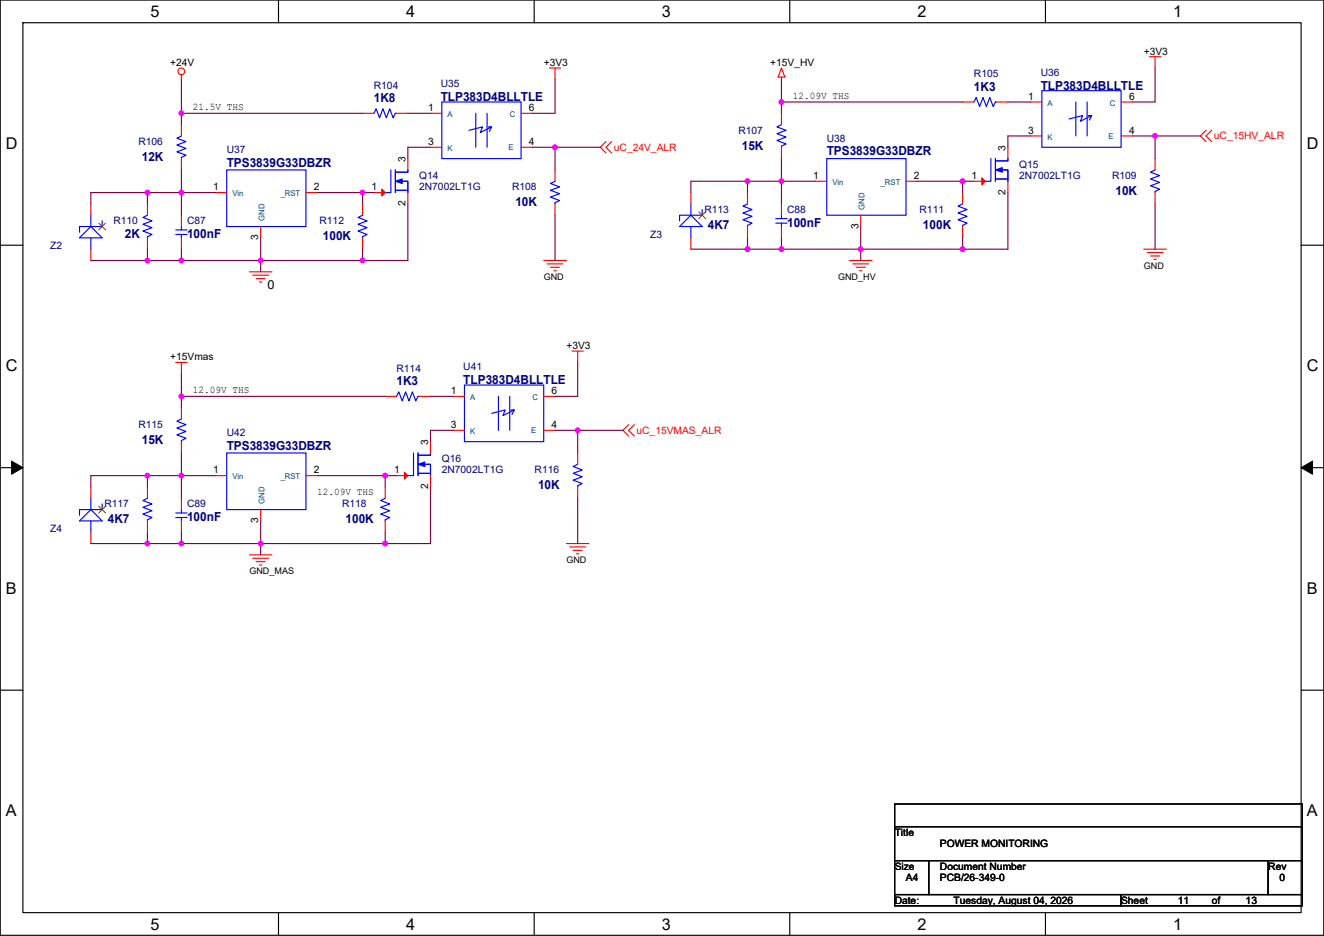
[picture p18: page 13]

D | D

280R

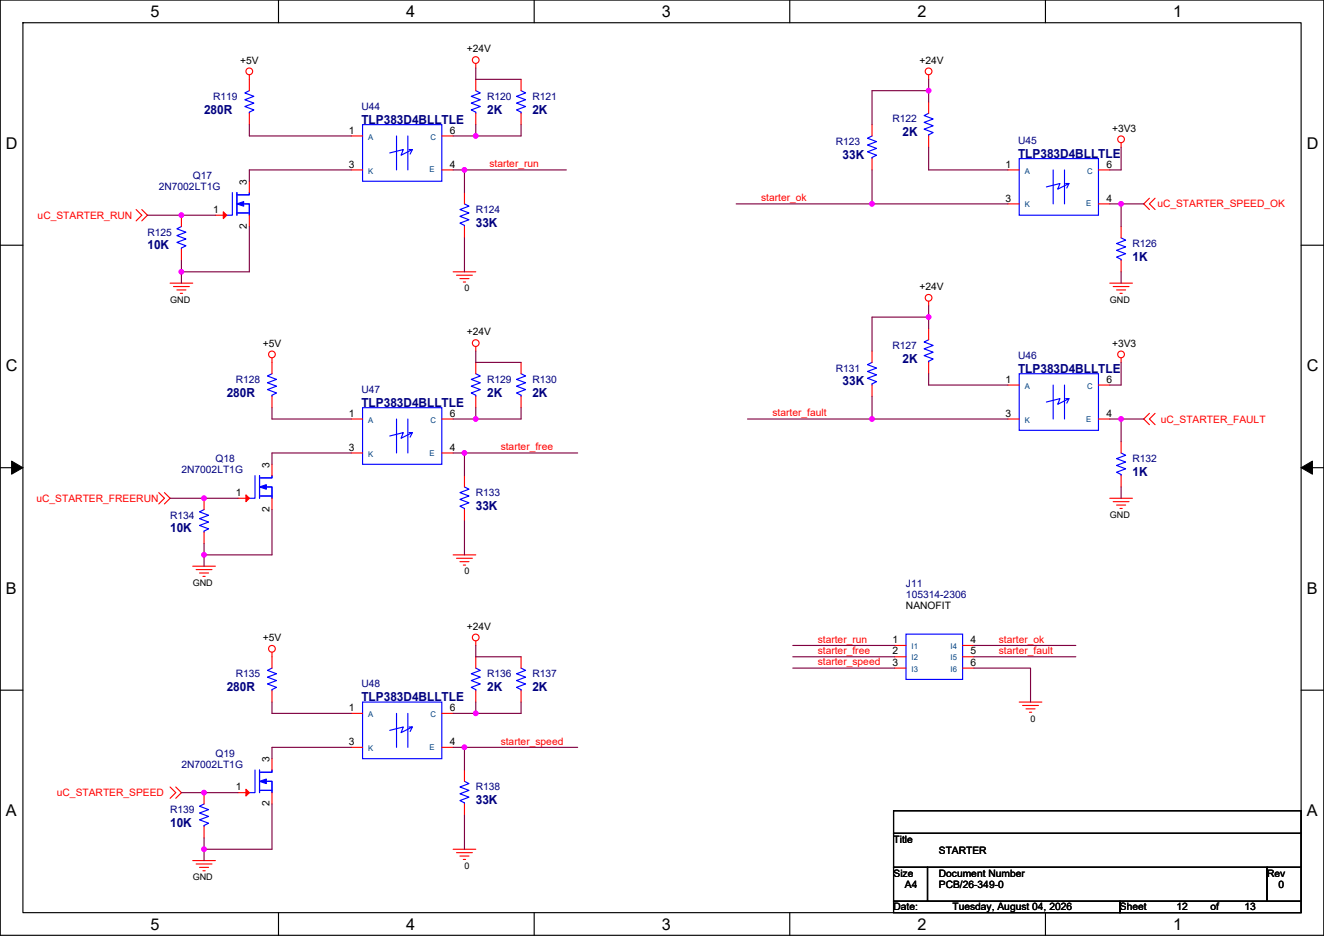
[picture p19: page 14]

D | D

### TLP383D4BLLTLE

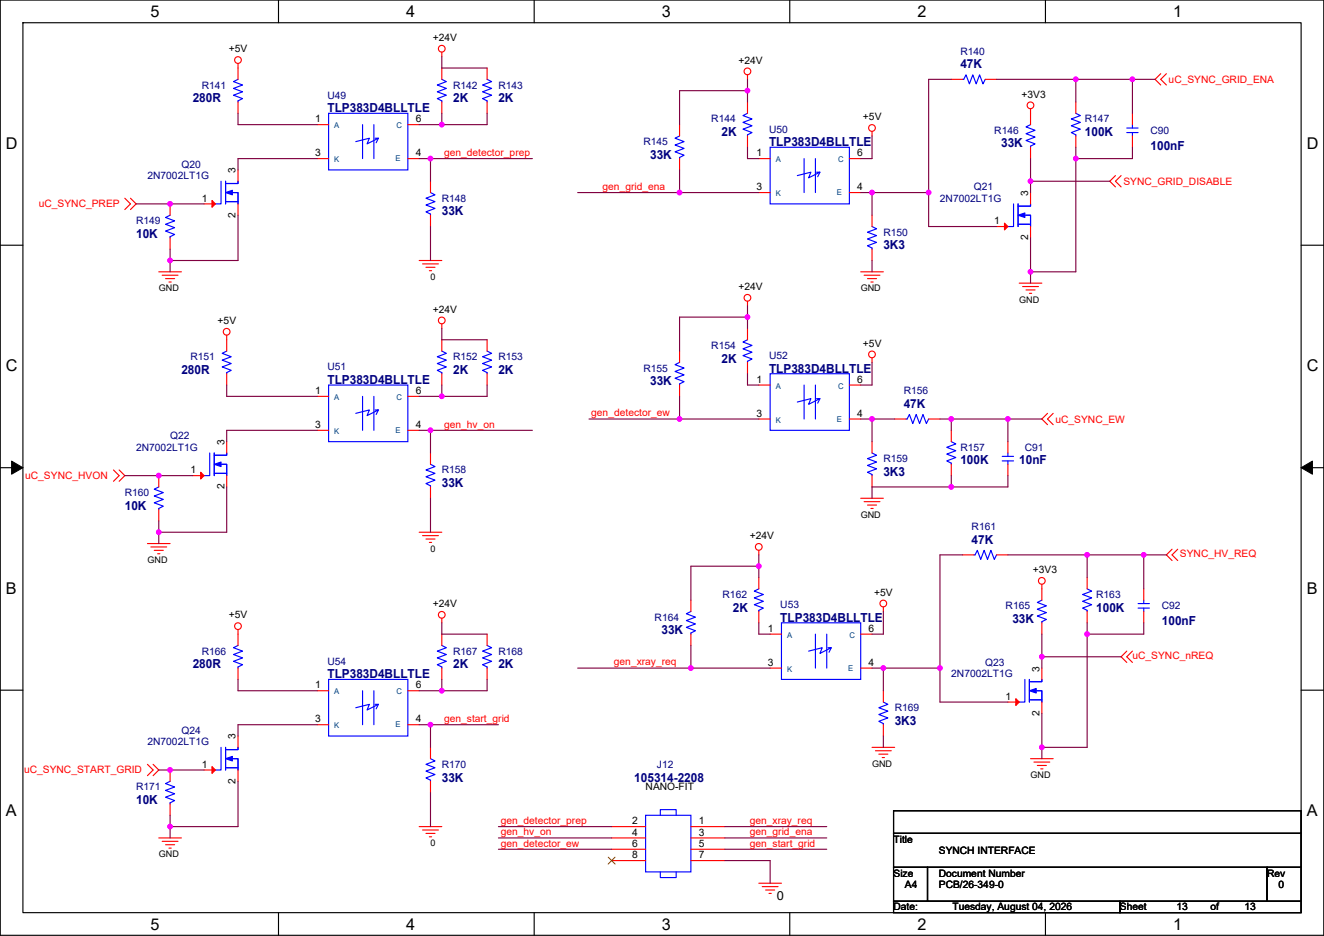
[picture p20: page 15]
