marcorispoli/PCB-26-349/ESECUTIVI/PF26-349-0.pdf

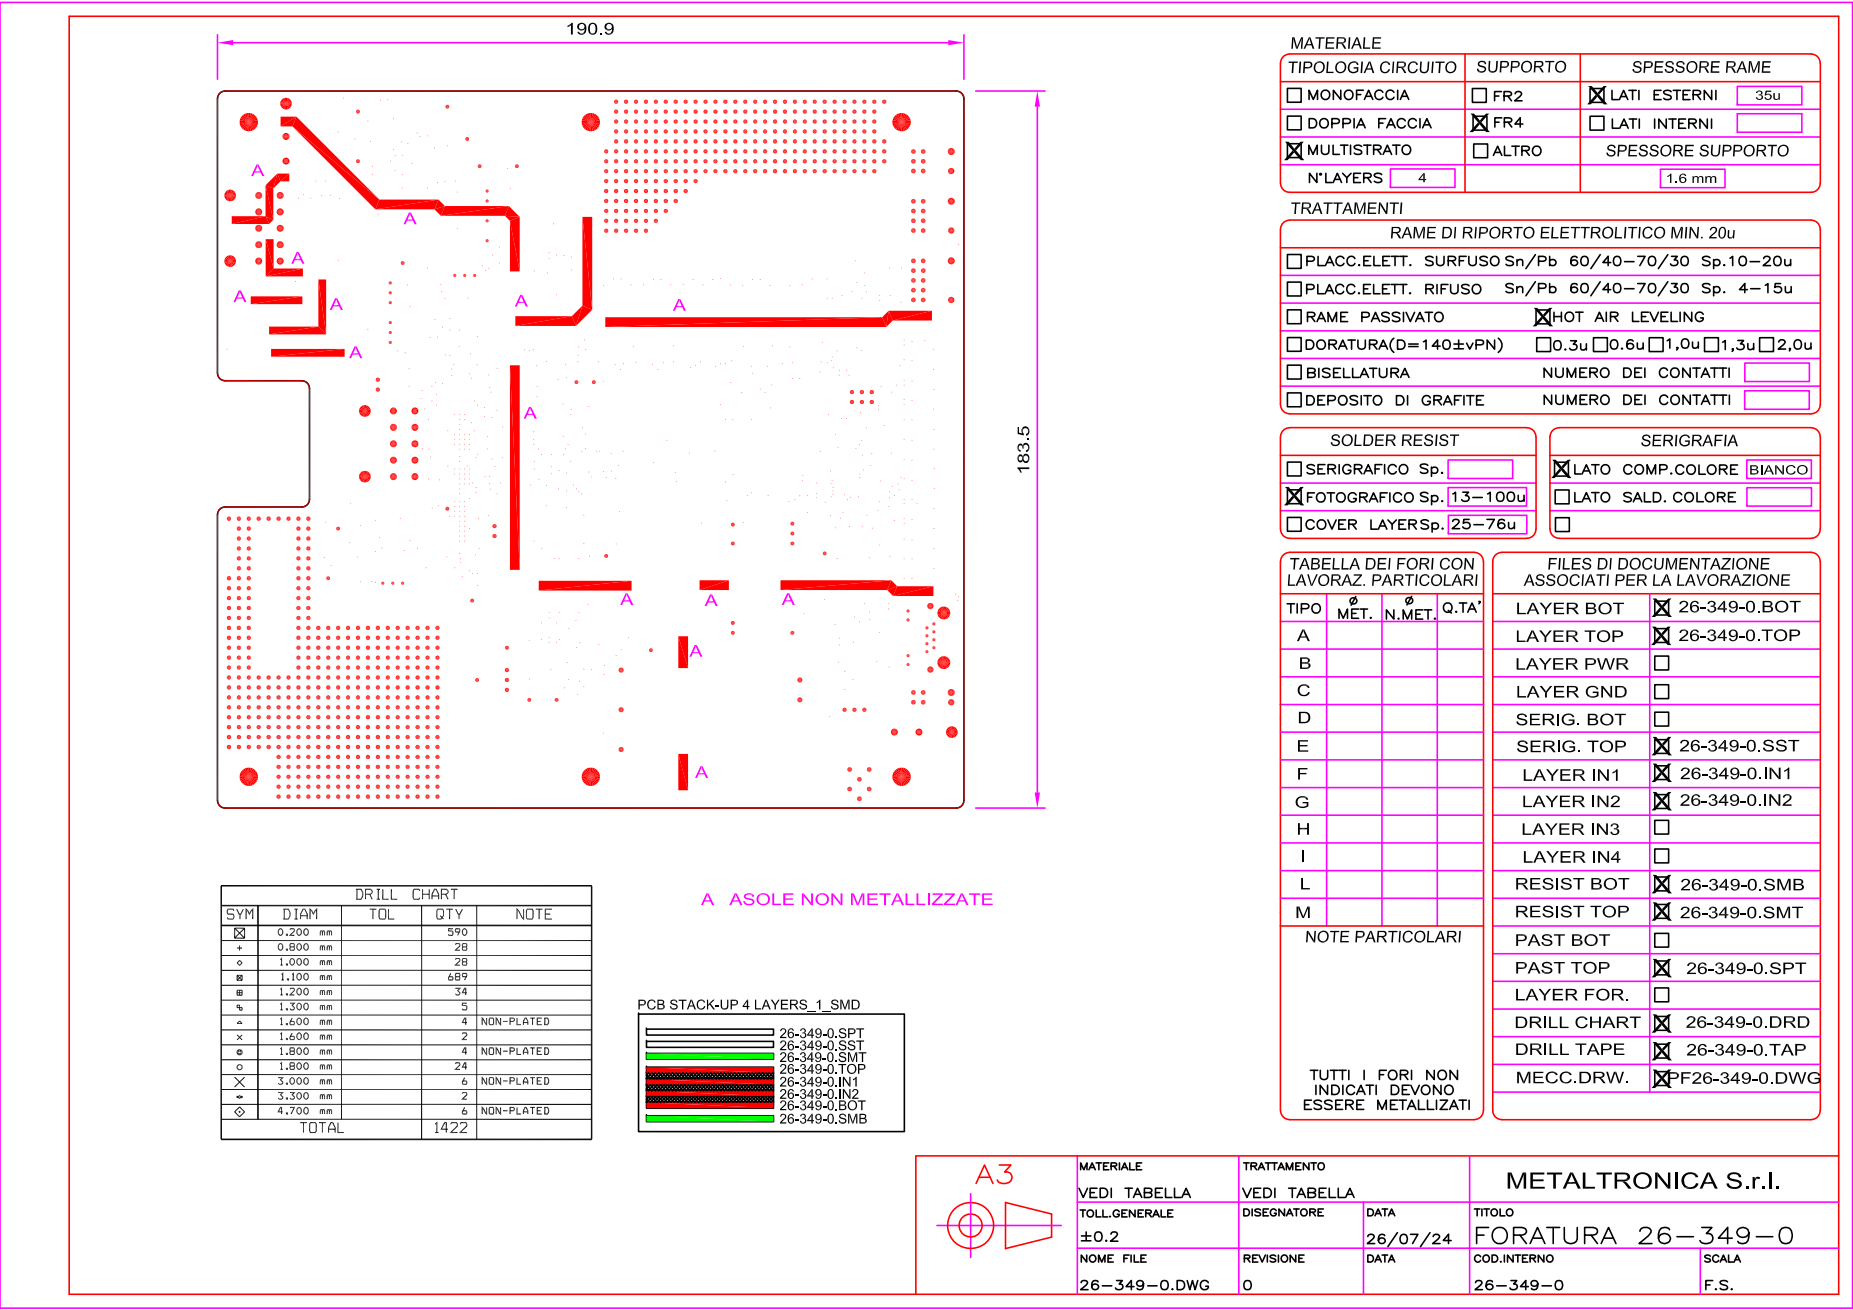
[picture p21: page 1]
