marcorispoli/PCB-26-349/ESECUTIVI/PM26-349-0.pdf

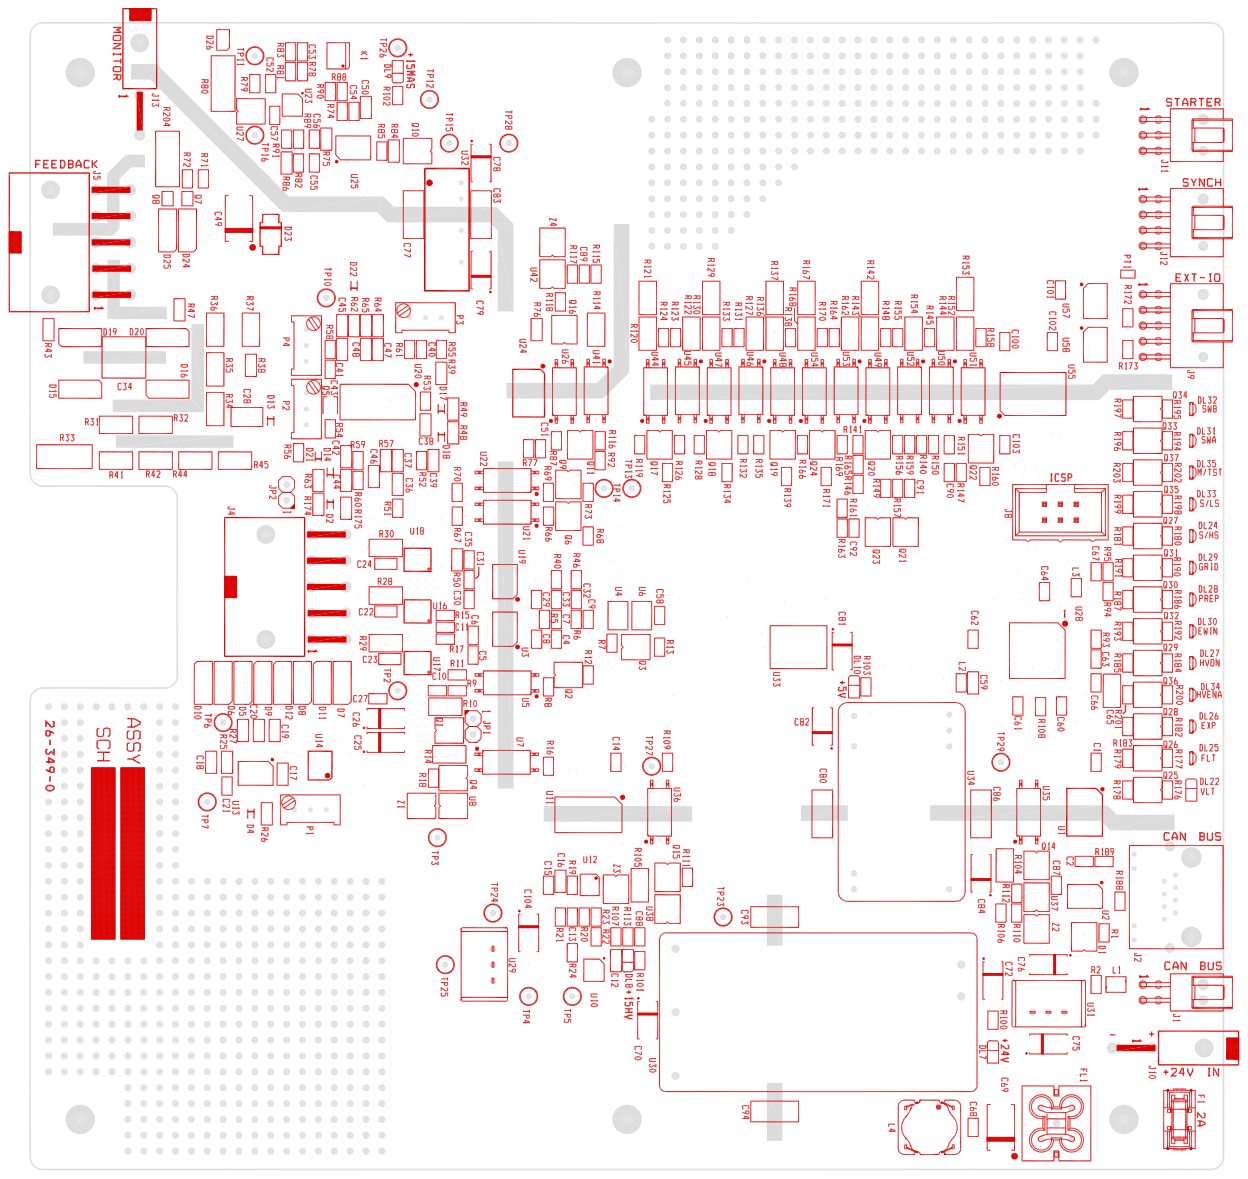
[picture p22: page 1]
