marcorispoli/PCB-26-349/(list of files, drawings)

Other design files:
ORCAD/LIBRARY.OLB
ORCAD/SE26-349-0.DSN
ORCAD/SE26-349-0.opj
