marcorispoli/PCB-26-349/(commit log)

2026-06-12 Creazione progetto a partire dalla PCB-05-190-3
    [5783-43 VALORIZZATA 18-12-18.xlsx, LP05-190-3-ASSY00_r03.xlsx, SE26-349-0.DSN, SE26-349-0.opj]
2026-06-15 Nuovi Aggiornamenti
    [SE26-349-0.DSN, SE26-349-0.opj]
2026-06-16 Completato schematico MAnca solo definizione filtraggio power Reference Verifica BOM
    [LIBRARY.OLB, SE26-349-0.DSN, SE26-349-0.opj]
2026-06-16 dimenticanza uC_MAINSW1 e 2 su micro
    [SE26-349-0.DSN]
2026-06-17 Aggiunto diagnostica e TLP383
    [LIBRARY.OLB, SE26-349-0.DSN, SE26-349-0.opj]
2026-06-18 Prossimo step: test points
    [LIBRARY.OLB, SE26-349-0.DSN, SE26-349-0.opj]
2026-06-19 Terminato lo schematico
    [SE26-349-0.DSN, SE26-349-0.opj]
2026-06-21 reference e Layout in corso
    [SE26-349-0.DSN, SE26-349-0.opj]
2026-06-22 Terminato progetto
    [SE26-349-0.DSN, SE26-349-0.opj]
2026-06-29 Ri-corretto stadio alimentazione:
    [SE26-349-0.DSN, SE26-349-0.opj]
2026-06-29 Aggiunta sezione segnali digitali extern
    [LIBRARY.OLB, SE26-349-0.DSN, SE26-349-0.opj]
2026-06-30 Unificato 5V interfacce esterne aggiunto fusibile ripristinabile 50mA Inserito DC/DC 5V sia su HV che su VEXT
    [LIBRARY.OLB, SE26-349-0.DSN, SE26-349-0.opj]
2026-08-02 Completato schematico con piazzamento in DXF
2026-10-20 Corretto BUG PAgina Power U32 girato ingresso uscito
2026-10-20 Corretto BUG su U25 (PN Errato e Footprint Errato)
2026-10-20 BUG: corretto simboli U57 e U58 e aggiornato nomi NET su connettore J9. Invertito Y con Z. Non cambia nulla a livello di routing, ma semplicemente cambiano i nomi delle net sul connettore
2026-10-20 BUG: Corretto U8 Invertito pin 3 con pin 1
